ZeroPhone/ZeroPhoneNext-PCB/bottom_board_palmtop/FSUSB42UMX.stp

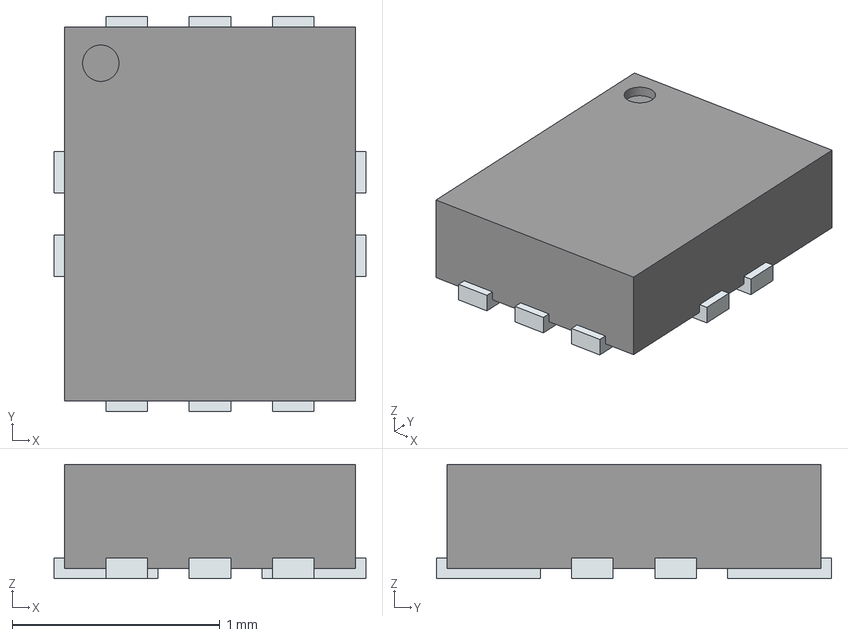
[picture p1: CAD file, 2026-03-20]
bottom_board_palmtop/FSUSB42UMX.stp
1.50 x 1.90 x 0.55 mm
PinsArrayLR
PinsArrayTB
