ZeroPhone/ZeroPhoneNext-PCB/top_board_pizero/CMNSM661004.stp

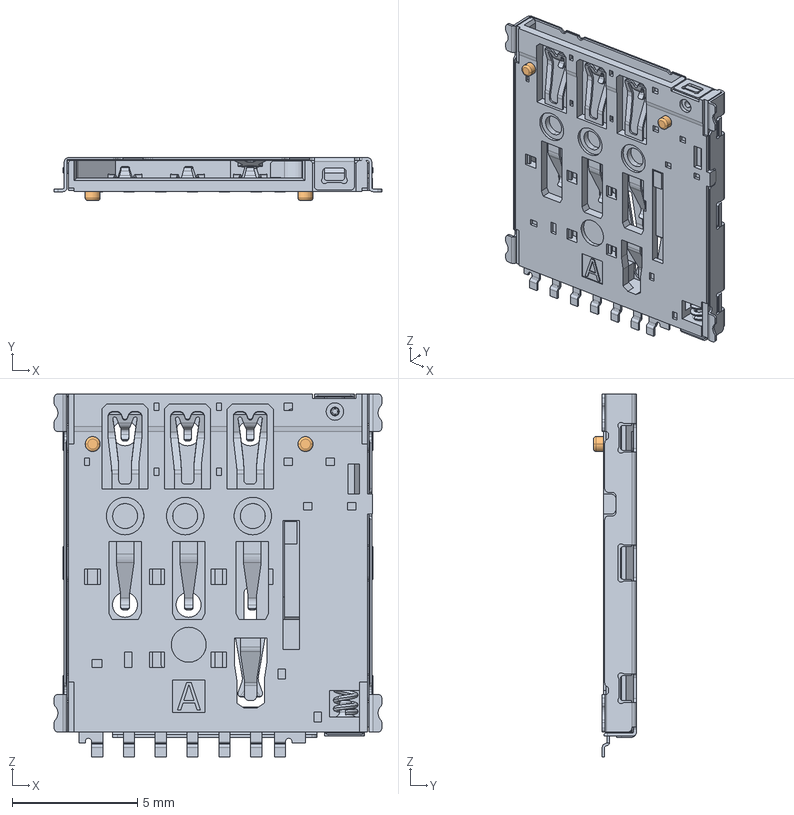
[picture p2: CAD file, 2026-03-20]
top_board_pizero/CMNSM661004.stp
13.1 x 1.72 x 14.5 mm
