ZeroPhone/ZeroPhoneNext-PCB/bottom_board_palmtop/battery.kicad_sch

## KiCad design bottom_board_palmtop/battery.kicad_sch (2026-03-31)

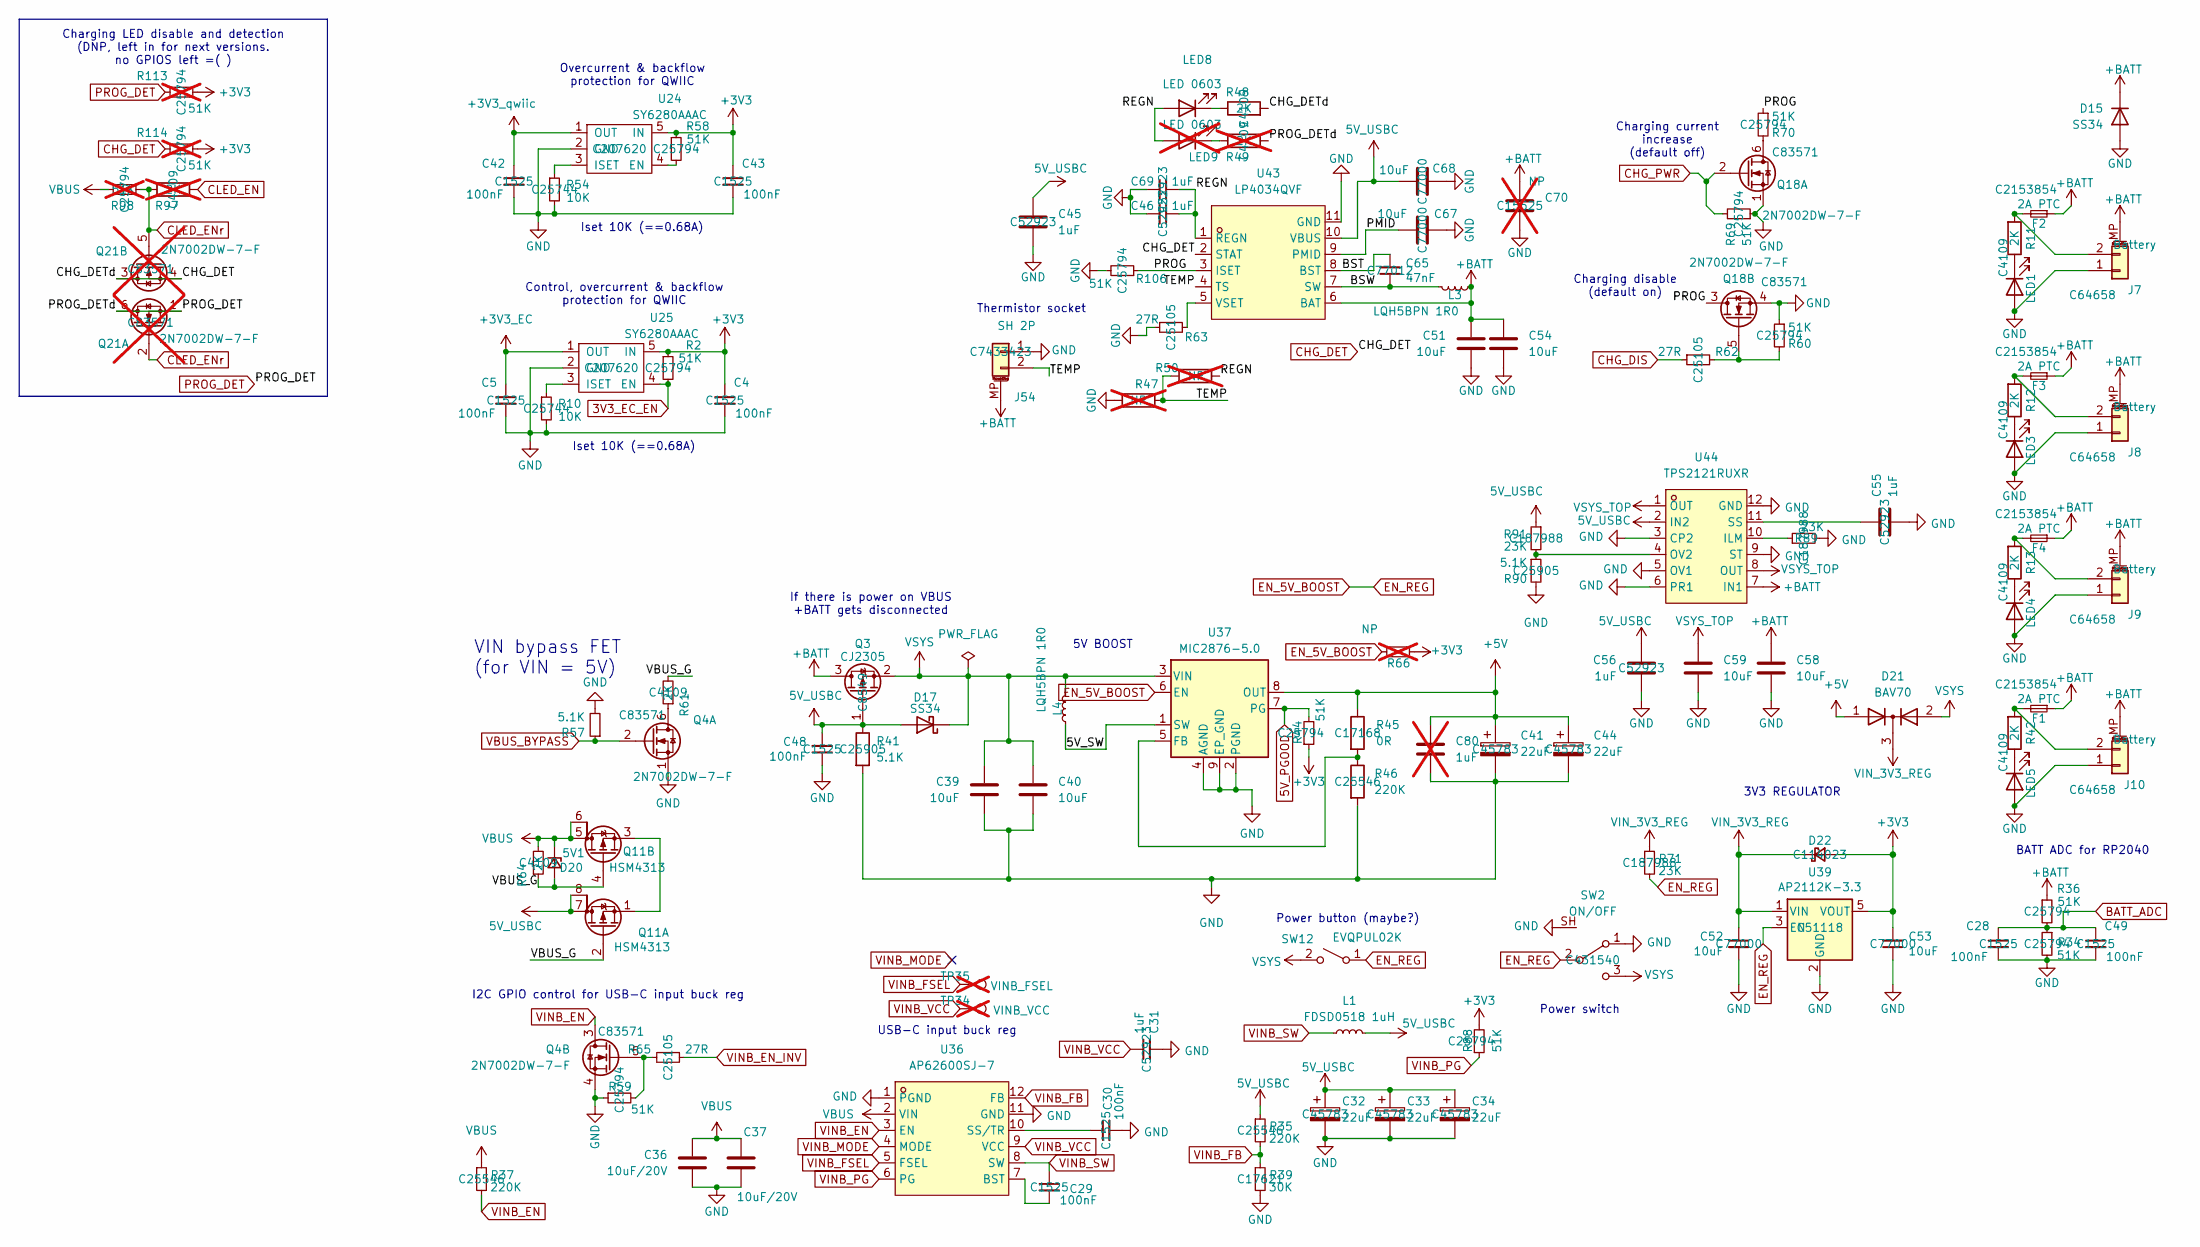
[picture p3: schematic battery.kicad_sch]

Parts:
C4, C5, C28, C29, C30, C42, C43, C48, C49: 100nF; C_0402_1005Metric; LCSC Part C1525
C31, C45, C46, C55, C56, C69: 1uF; C_0402_1005Metric; LCSC Part C52923
C32, C33, C34, C41, C44: 22uF; C_0805_2012Metric_Pad1.18x1.45mm_HandSolder; LCSC Part C45783
C36, C37: 10uF/20V; C_0805_2012Metric_Pad1.18x1.45mm_HandSolder
C39, C40, C51, C54, C58, C59: 10uF; C_0805_2012Metric_Pad1.18x1.45mm_HandSolder
C52, C53, C67, C68: 10uF; C_0402_1005Metric; LCSC Part C77000
C65: 47nF; C_0402_1005Metric; LCSC Part C77012
C70: NP; C_0402_1005Metric; LCSC Part C15525; not fitted
C80: 1uF; C_0805_2012Metric_Pad1.18x1.45mm_HandSolder; not fitted
D15, D17: SS34; D_SMA
D20: 5V1; D_0805_2012Metric
D21: BAV70; SOT-23; LCSC Part C2501
D22: D_Schottky_Small; D_SOD-323; LCSC Part C114023
F1, F2, F3, F4: 2A PTC; Fuse_1206_3216Metric; LCSC Part C2153854
J7, J8, J9, J10: Battery; JST_PH_B2B-PH-SM4-TB_1x02-1MP_P2.00mm_Vertical; LCSC Part C64658
J54: SH 2P; JST_SH_BM02B-SRSS-TB_1x02-1MP_P1.00mm_Vertical; LCSC Part C7433423
L1: FDSD0518 1uH; L_Murata_FDSD0518; LCSC Part C7511322
L3, L4: LQH5BPN 1R0; L_Murata_LQH5BPN; LCSC Part C337906
LED1, LED3, LED4, LED5: LED 0603 Orange; LED_0603_1608Metric; LCSC Part C965801
LED8: LED 0603; LED_0603_1608Metric; LCSC Part C965808
LED9: LED 0603; LED_0603_1608Metric; LCSC Part C965804; not fitted
Q3: CJ2305; SOT-23; LCSC Part C8549
Q4, Q18: 2N7002DW-7-F; SOT-363_SC-70-6; LCSC Part C83571
Q11: HSM4313; SO-8_3.9x4.9mm_P1.27mm
Q21: 2N7002DW-7-F; SOT-363_SC-70-6; LCSC Part C83571; not fitted
R2, R34, R36, R44, R58, R59, R60, R69, R70, R88, R106: 51K; R_0402_1005Metric; LCSC Part C25794
R10, R54: 10K; R_0402_1005Metric; LCSC Part C25744
R11, R12, R13, R42, R48, R61, R64: 2K; R_0402_1005Metric; LCSC Part C4109
R35, R37, R46: 220K; R_0402_1005Metric; LCSC Part C25546
R39: 30K; R_0402_1005Metric; LCSC Part C17621
R41, R57, R90: 5.1K; R_0402_1005Metric; LCSC Part C25905
R45: 0R; R_0402_1005Metric; LCSC Part C17168
R47, R50: NP; R_0603_1608Metric; not fitted
R49, R97: 2K; R_0402_1005Metric; LCSC Part C4109; not fitted
R62, R63, R65: 27R; R_0402_1005Metric; LCSC Part C25105
R66: NP; R_0402_1005Metric; LCSC Part C25794; not fitted
R71, R89, R91: 23K; R_0402_1005Metric; LCSC Part C187988
R98, R113, R114: 51K; R_0402_1005Metric; LCSC Part C25794; not fitted
SW2: ON/OFF; SW_SPDT_PCM12_SH; LCSC Part C431540
SW12: EVQPUL02K; Panasonic_EVQPUL_EVQPUC
TP34: VINB_VCC; TestPoint_Pad_0.6x0.6mm; not fitted
TP35: VINB_FSEL; TestPoint_Pad_0.6x0.6mm; not fitted
U24, U25: SY6280AAAC; SOT-23-5; LCSC Part C207620
U36: AP62600SJ-7; QFN-12_L3.0-W2.0-P0.50-TL_AP62600SJ-7; LCSC Part C4748917
U37: MIC2876-5.0; DFN-8-1EP_2x2mm_P0.5mm_EP0.6x1.2mm
U39: AP2112K-3.3; SOT-23-5; LCSC Part C51118
U43: LP4034QVF; DFN-10-1EP_3x3mm_P0.5mm_EP1.58x2.35mm; LCSC Part C42460070
U44: TPS2121RUXR; VQFN-HR-12_L2.5-W2.0-P0.50-BL; LCSC Part C485916

Connections:
3V3_EC_EN: R2.2, U25.4 (EN)
5V_PGOOD: R44.2, U37.7 (PG)
5V_SW: L4.1, U37.1 (SW)
5V_USBC: C32.1, C33.1, C34.1, C45.1, C48.2, C56.1, C68.1, D17.2 (A), L1.2, Q3.1 (G), Q11.7 (D), Q11.8 (G), R35.1, R41.1, R91.1, U43.10 (VBUS), U44.2 (IN2)
+3V3: C4.1, C43.1, C53.2, D22.2 (A), R2.1, R44.1, R58.1, R66.2, R88.2, R113.2, R114.2, U24.5 (IN), U25.5 (IN), U39.5 (VOUT)
+3V3_EC: C5.1, U25.1 (OUT)
+3V3_qwiic: C42.1, U24.1 (OUT)
+5V: C41.1, C44.1, C80.1, D21.1 (A), R45.1, U37.8 (OUT)
+BATT: C51.2, C54.2, C58.2, C70.1, D15.1 (K), F1.1, F2.1, F3.1, F4.1, J7.MP (MountPin), J8.MP (MountPin), J9.MP (MountPin), J10.MP (MountPin), J54.MP (MountPin), L3.1, Q3.3 (D), R36.1, U43.6 (BAT), U44.7 (IN1)
BATT_ADC: C28.1, C49.1, R34.1, R36.2
BST: C65.2, U43.8 (BST)
BSW: C65.1, L3.2, U43.7 (SW)
CHG_DET: Q21.3 (D), Q21.4 (S), R48.2, R114.1, U43.2 (STAT)
CHG_DIS: R62.1
CHG_PWR: Q18.2 (G), R69.2
CLED_EN: R97.2
CLED_ENr: Q21.2 (G), Q21.5 (G), R97.1, R98.2
EN_5V_BOOST: R66.1, R71.2, SW2.2 (B), SW12.1 (A), U37.6 (EN), U39.3 (EN)
GND: C4.2, C5.2, C28.2, C30.2, C31.2, C32.2, C33.2, C34.2, C36.1, C37.1, C39.1, C40.1, C41.2, C42.2, C43.2, C44.2, C45.2, C46.2, C48.1, C49.2, C51.1, C52.2, C53.1, C54.1, C55.2, C56.2, C58.1, C59.1, C67.2, C68.2, C69.2, C70.2, C80.2, D15.2 (A), J7.1, J8.1, J9.1, J10.1, J54.1, LED1.2 (A), LED3.2 (A), LED4.2 (A), LED5.2 (A), Q4.1 (S), Q4.4 (S), Q18.1 (S), Q18.4 (S), R10.2, R34.2, R39.2, R41.2, R46.2, R47.2, R54.2, R57.2, R59.1, R60.1, R63.1, R69.1, R89.2, R90.2, R106.2, SW2.1 (A), SW2.SH, U24.2 (GND), U25.2 (GND), U36.1 (PGND), U36.11 (GND), U37.2 (PGND), U37.4 (AGND), U37.9 (EP_GND), U39.2 (GND), U43.11 (GND), U44.3 (CP2), U44.5 (OV1), U44.6 (PR1), U44.9 (ST), U44.12 (GND)
unnamed: C29.2, U36.7 (BST)
unnamed: C30.1, U36.10 (SS/TR)
unnamed: C55.1, U44.11 (SS)
unnamed: F1.2, J10.2, R42.2
unnamed: F2.2, J7.2, R11.2
unnamed: F3.2, J8.2, R12.2
unnamed: F4.2, J9.2, R13.2
unnamed: LED1.1 (K), R11.1
unnamed: LED3.1 (K), R12.1
unnamed: LED4.1 (K), R13.1
unnamed: LED5.1 (K), R42.1
unnamed: LED8.1 (K), R48.1
unnamed: LED9.1 (K), R49.1
unnamed: Q4.5 (G), R59.2, R65.2
unnamed: Q4.6 (D), R61.1
unnamed: Q11.1 (S), Q11.3 (S)
unnamed: Q18.5 (G), R60.2, R62.2
unnamed: Q18.6 (D), R70.2
unnamed: R10.1, U25.3 (ISET)
unnamed: R45.2, R46.1, U37.5 (FB)
unnamed: R54.1, U24.3 (ISET)
unnamed: R58.2, U24.4 (EN)
unnamed: R63.2, U43.5 (VSET)
unnamed: R89.1, U44.10 (ILM)
unnamed: R90.1, R91.2, U44.4 (OV2)
PMID: C67.1, U43.9 (PMID)
PROG: Q18.3 (D), R70.1, R106.1, U43.3 (ISET)
PROG_DET: Q21.1 (S), Q21.6 (D), R49.2, R113.1
REGN: C46.1, C69.1, LED8.2 (A), LED9.2 (A), R50.1, U43.1 (REGN)
TEMP: J54.2, R47.1, R50.2, U43.4 (TS)
VBUS: C36.2, C37.2, D20.1 (K), Q11.5 (D), Q11.6 (G), R37.1, R64.2, R98.1, U36.2 (VIN)
VBUS_BYPASS: Q4.2 (G), R57.1
VBUS_G: D20.2 (A), Q11.2 (G), Q11.4 (G), R61.2, R64.1
VINB_EN: Q4.3 (D), R37.2, U36.3 (EN)
VINB_EN_INV: R65.1
VINB_FB: R35.2, R39.1, U36.12 (FB)
VINB_FSEL: TP35.1, U36.5 (FSEL)
VINB_MODE: U36.4 (MODE)
VINB_PG: R88.1, U36.6 (PG)
VINB_SW: C29.1, L1.1, U36.8 (SW)
VINB_VCC: C31.1, TP34.1, U36.9 (VCC)
VIN_3V3_REG: C52.1, D21.3 (K), D22.1 (K), R71.1, U39.1 (VIN)
VSYS: C39.2, C40.2, D17.1 (K), D21.2 (A), L4.2, Q3.2 (S), SW2.3 (C), SW12.2 (B), U37.3 (VIN)
VSYS_TOP: C59.2, U44.1 (OUT), U44.8 (OUT)

Notes on the sheet:
VIN bypass FET (for VIN = 5V)
5V BOOST
Power button (maybe?)
I2C GPIO control for USB-C input buck reg
Overcurrent & backflow protection for QWIIC
Iset 10K (==0.68A)
Control, overcurrent & backflow protection for QWIIC
Thermistor socket
BATT ADC for RP2040
Power switch
3V3 REGULATOR
If there is power on VBUS +BATT gets disconnected
Charging current increase (default off)
USB-C input buck reg
Charging disable (default on)
Charging LED disable and detection (DNP, left in for next versions. no GPIOS left =( )
