ZeroPhone/ZeroPhoneNext-PCB/bottom_board_palmtop/bottom_board_palmtop.kicad_sch

## KiCad design bottom_board_palmtop/bottom_board_palmtop.kicad_sch (2026-03-30)

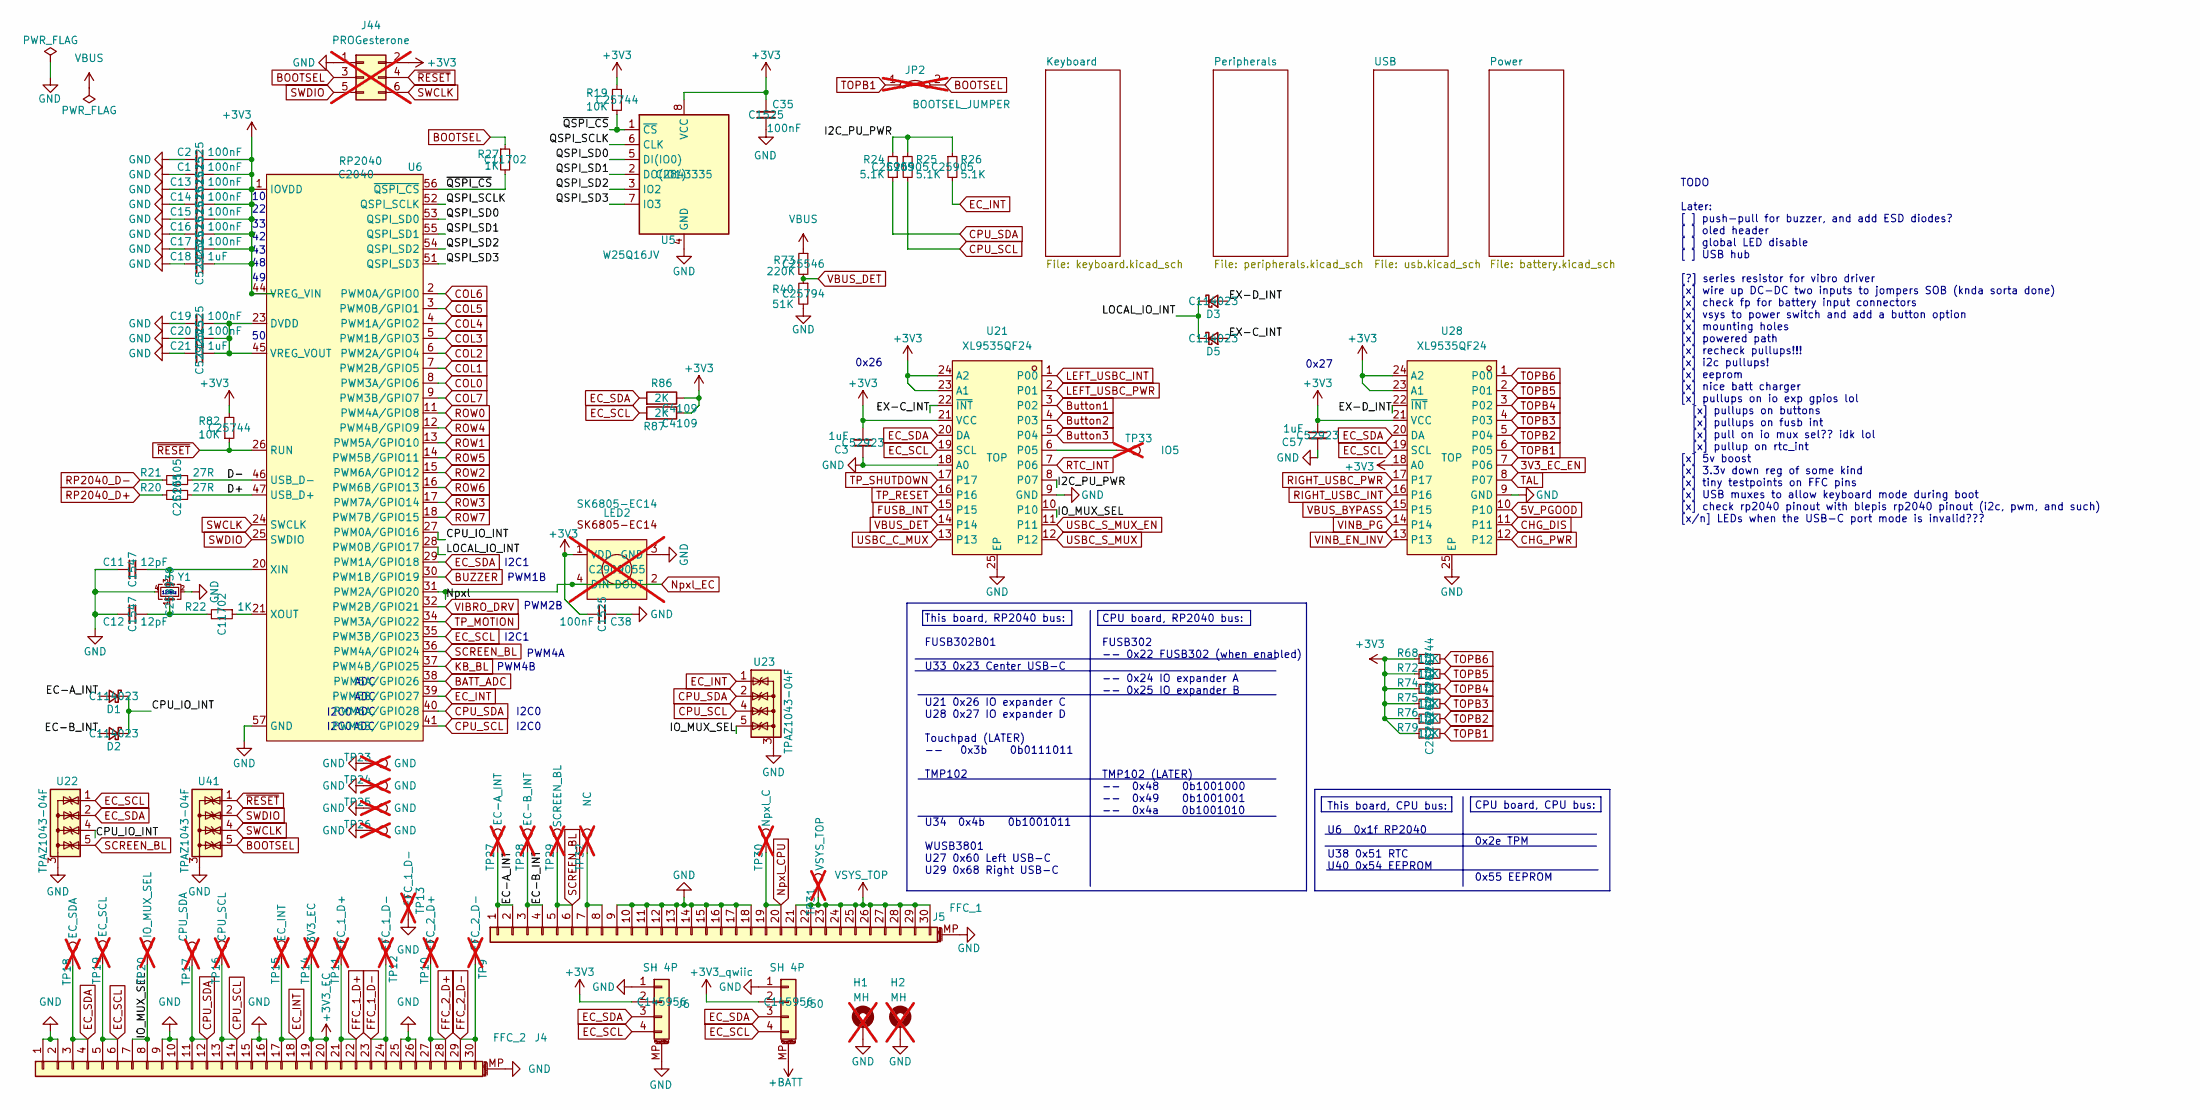
[picture p4: schematic bottom_board_palmtop.kicad_sch]

Parts:
C1, C2, C13, C14, C15, C16, C17, C19, C20, C35, C38: 100nF; C_0402_1005Metric; LCSC Part C1525
C3, C18, C21, C57: 1uF; C_0402_1005Metric; LCSC Part C52923
C11, C12: 12pF; C_0402_1005Metric; LCSC Part C1547
D1, D2, D3, D5: D_Schottky_Small; D_SOD-323; LCSC Part C114023
H1, H2: MH; MountingHole_2.5mm_Pad; not fitted
J4: FFC_2; FPC-SMD_30P-P0.50_XF3M-3015-1B; LCSC Part C5700582
J5: FFC_1; FPC-SMD_30P-P0.50_XF3M-3015-1B; LCSC Part C5700582
J6, J50: SH 4P; JST_SH_SM04B-SRSS-TB_1x04-1MP_P1.00mm_Horizontal; LCSC Part C145956
J44: PROGesterone; PinHeader_2x03_P2.54mm_Vertical_PROG; not fitted
JP2: BOOTSEL_JUMPER; SolderJumper-2_P1.3mm_Bridged_RoundedPad1.0x1.5mm; not fitted
LED2: SK6805-EC14; LCSC Part C2909055; not fitted
R19, R68, R72, R74, R75, R76, R79, R82: 10K; R_0402_1005Metric; LCSC Part C25744
R20, R21: 27R; R_0402_1005Metric; LCSC Part C25105
R22, R27: 1K; R_0402_1005Metric; LCSC Part C11702
R24, R25, R26: 5.1K; R_0402_1005Metric; LCSC Part C25905
R40: 51K; R_0402_1005Metric; LCSC Part C25794
R73: 220K; R_0402_1005Metric; LCSC Part C25546
R86, R87: 2K; R_0402_1005Metric; LCSC Part C4109
TP9: FFC_2_D-; TestPoint_Pad_0.6x0.6mm; not fitted
TP10: FFC_2_D+; TestPoint_Pad_0.6x0.6mm; not fitted
TP11: FFC_1_D+; TestPoint_Pad_0.6x0.6mm; not fitted
TP12, TP13: FFC_1_D-; TestPoint_Pad_0.6x0.6mm; not fitted
TP14: 3V3_EC; TestPoint_Pad_0.6x0.6mm; not fitted
TP15: EC_INT; TestPoint_Pad_0.6x0.6mm; not fitted
TP16: CPU_SCL; TestPoint_Pad_0.6x0.6mm; not fitted
TP17: CPU_SDA; TestPoint_Pad_0.6x0.6mm; not fitted
TP18: EC_SDA; TestPoint_Pad_0.6x0.6mm; not fitted
TP19: EC_SCL; TestPoint_Pad_0.6x0.6mm; not fitted
TP20: IO_MUX_SEL; TestPoint_Pad_0.6x0.6mm; not fitted
TP23, TP24, TP25, TP26: GND; TestPoint_Pad_0.6x0.6mm; not fitted
TP27: EC-A_INT; TestPoint_Pad_0.6x0.6mm; not fitted
TP28: EC-B_INT; TestPoint_Pad_0.6x0.6mm; not fitted
TP29: SCREEN_BL; TestPoint_Pad_0.6x0.6mm; not fitted
TP30: Npxl_C; TestPoint_Pad_0.6x0.6mm; not fitted
TP31: VSYS_TOP; TestPoint_Pad_0.6x0.6mm; not fitted
TP32: NC; TestPoint_Pad_0.6x0.6mm; not fitted
TP33: IO5; TestPoint_Pad_0.6x0.6mm; not fitted
U5: W25Q16JV; DFN-8-1EP_3x2mm_P0.5mm_EP1.3x1.5mm; LCSC Part C2843335
U6: RP2040; QFN-56-1EP_7x7mm_P0.4mm_EP5.6x5.6mm; LCSC Part C2040
U21, U28: XL9535QF24; QFN-24-1EP_4x4mm_P0.5mm_EP2.5x2.5mm; LCSC Part C5444301
U22, U23, U41: TPAZ1043-04F; USON-10_2.5x1.0mm_P0.5mm
Y1: 12MHz; Crystal_SMD_3225-4Pin_3.2x2.5mm; LCSC Part C258938

Connections:
3V3_EC_EN: U28.7 (P06)
5V_PGOOD: U28.10
+3V3: C1.1, C2.1, C3.1, C13.1, C14.1, C15.1, C16.1, C17.1, C18.1, C35.1, C38.1, C57.1, J6.2, J44.2, LED2.1 (VDD), R19.2, R68.1, R72.1, R74.1, R75.1, R76.1, R79.1, R82.2, R86.1, R87.1, U5.8 (VCC), U6.1 (IOVDD), U6.10 (IOVDD), U6.22 (IOVDD), U6.33 (IOVDD), U6.42 (IOVDD), U6.43 (ADC_AVDD), U6.44 (VREG_VIN), U6.48 (USB_VDD), U6.49 (IOVDD), U21.21 (VCC), U21.23 (A1), U21.24 (A2), U28.18 (A0), U28.21 (VCC), U28.23 (A1), U28.24 (A2)
+3V3_EC: J4.19, J4.20, TP14.1
+3V3_qwiic: J50.2
+BATT: J50.MP (MountPin)
BATT_ADC: U6.38 (PWM5A/GPIO26)
BOOTSEL: J44.3, JP2.2 (B), R27.1, U41.5 (IO4), U41.6 (NC)
BUZZER: U6.30 (PWM1B/GPIO19)
Button1: U21.3 (P02)
Button2: U21.4 (P03)
Button3: U21.5 (P04)
CHG_DIS: U28.11
CHG_PWR: U28.12
COL0: U6.8 (PWM3A/GPIO6)
COL1: U6.7 (PWM2B/GPIO5)
COL2: U6.6 (PWM2A/GPIO4)
COL3: U6.5 (PWM1B/GPIO3)
COL4: U6.4 (PWM1A/GPIO2)
COL5: U6.3 (PWM0B/GPIO1)
COL6: U6.2 (PWM0A/GPIO0)
COL7: U6.9 (PWM3B/GPIO7)
CPU_IO_INT: D1.1 (K), D2.1 (K), U6.27 (PWM0A/GPIO16), U22.4 (IO3), U22.7 (NC)
CPU_SCL: J4.13, J4.14, R25.2, TP16.1, U6.41 (PWM6B/GPIO29), U23.4 (IO3), U23.7 (NC)
CPU_SDA: J4.11, J4.12, R24.1, TP17.1, U6.40 (PWM6A/GPIO28), U23.2 (IO2), U23.9 (NC)
D+: R20.1, U6.47 (USB_D+)
D-: R21.1, U6.46 (USB_D-)
EC-A_INT: D1.2 (A), J5.1, J5.2, TP27.1
EC-B_INT: D2.2 (A), J5.3, J5.4, TP28.1
EC_INT: J4.17, J4.18, R26.2, TP15.1, U6.39 (PWM5B/GPIO27), U23.1 (IO1), U23.10 (NC)
EC_SCL: J4.5, J4.6, J6.4, J50.4, R87.2, TP19.1, U6.35 (PWM3B/GPIO23), U21.19 (SCL), U22.1 (IO1), U22.10 (NC), U28.19 (SCL)
EC_SDA: J4.3, J4.4, J6.3, J50.3, R86.2, TP18.1, U6.29 (PWM1A/GPIO18), U21.20 (DA), U22.2 (IO2), U22.9 (NC), U28.20 (DA)
EX-C_INT: D5.2 (A), U21.22 (~INT)
EX-D_INT: D3.2 (A), U28.22 (~INT)
FFC_1_D+: J4.21, J4.22, TP11.1
FFC_1_D-: J4.23, J4.24, TP12.1
FFC_2_D+: J4.27, J4.28, TP10.1
FFC_2_D-: J4.29, J4.30, TP9.1
FUSB_INT: U21.15
GND: C1.2, C2.2, C3.2, C11.2, C12.2, C13.2, C14.2, C15.2, C16.2, C17.2, C18.2, C19.2, C20.2, C21.2, C35.2, C38.2, C57.2, H1.1, H2.1, J4.1, J4.2, J4.9, J4.10, J4.15, J4.16, J4.25, J4.26, J4.MP (MountPin), J5.9, J5.10, J5.11, J5.12, J5.13, J5.14, J5.15, J5.16, J5.17, J5.18, J5.MP (MountPin), J6.1, J6.MP (MountPin), J44.1, J50.1, LED2.3 (GND), R40.2, TP13.1, TP23.1, TP24.1, TP25.1, TP26.1, U5.4 (GND), U6.19 (TESTEN), U6.57 (GND), U21.9 (GND), U21.18 (A0), U21.25 (EP), U22.3 (G), U22.8 (G), U23.3 (G), U23.8 (G), U28.9 (GND), U28.25 (EP), U41.3 (G), U41.8 (G), Y1.2, Y1.4
I2C_PU_PWR: R24.2, R25.1, R26.1, U21.8 (P07)
IO_MUX_SEL: J4.7, J4.8, TP20.1, U21.10, U23.5 (IO4), U23.6 (NC)
KB_BL: U6.37 (PWM4B/GPIO25)
LEFT_USBC_INT: U21.1 (P00)
LEFT_USBC_PWR: U21.2 (P01)
LOCAL_IO_INT: D3.1 (K), D5.1 (K), U6.28 (PWM0B/GPIO17)
unnamed: C11.1, U6.20 (XIN), Y1.3
unnamed: C12.1, R22.2, Y1.1
unnamed: C19.1, C20.1, C21.1, U6.23 (DVDD), U6.45 (VREG_VOUT), U6.50 (DVDD)
unnamed: J5.7, J5.8, TP32.1
unnamed: R22.1, U6.21 (XOUT)
unnamed: TP33.1, U21.6 (P05)
Npxl_CPU: J5.19, J5.20, TP30.1
Npxl_EC: LED2.2 (DOUT), LED2.4 (DIN), U6.31 (PWM2A/GPIO20)
QSPI_SCLK: U5.6 (CLK), U6.52 (QSPI_SCLK)
QSPI_SD0: U5.5 (DI(IO0)), U6.53 (QSPI_SD0)
QSPI_SD1: U5.2 (DO(IO1)), U6.55 (QSPI_SD1)
QSPI_SD2: U5.3 (IO2), U6.54 (QSPI_SD2)
QSPI_SD3: U5.7 (IO3), U6.51 (QSPI_SD3)
RIGHT_USBC_INT: U28.16
RIGHT_USBC_PWR: U28.17
ROW0: U6.11 (PWM4A/GPIO8)
ROW1: U6.13 (PWM5A/GPIO10)
ROW2: U6.15 (PWM6A/GPIO12)
ROW3: U6.17 (PWM7A/GPIO14)
ROW4: U6.12 (PWM4B/GPIO9)
ROW5: U6.14 (PWM5B/GPIO11)
ROW6: U6.16 (PWM6B/GPIO13)
ROW7: U6.18 (PWM7B/GPIO15)
RP2040_D+: R20.2
RP2040_D-: R21.2
RTC_INT: U21.7 (P06)
SCREEN_BL: J5.5, J5.6, TP29.1, U6.36 (PWM4A/GPIO24), U22.5 (IO4), U22.6 (NC)
SWCLK: J44.6, U6.24 (SWCLK), U41.4 (IO3), U41.7 (NC)
SWDIO: J44.5, U6.25 (SWDIO), U41.2 (IO2), U41.9 (NC)
TAL: U28.8 (P07)
TOPB1: JP2.1 (A), R79.2, U28.6 (P05)
TOPB2: R76.2, U28.5 (P04)
TOPB3: R75.2, U28.4 (P03)
TOPB4: R74.2, U28.3 (P02)
TOPB5: R72.2, U28.2 (P01)
TOPB6: R68.2, U28.1 (P00)
TP_MOTION: U6.34 (PWM3A/GPIO22)
TP_RESET: U21.16
TP_SHUTDOWN: U21.17
USBC_C_MUX: U21.13
USBC_S_MUX: U21.12
USBC_S_MUX_EN: U21.11
VBUS: R73.1
VBUS_BYPASS: U28.15
VBUS_DET: R40.1, R73.2, U21.14
VIBRO_DRV: U6.32 (PWM2B/GPIO21)
VINB_EN_INV: U28.13
VINB_PG: U28.14
VSYS_TOP: J5.21, J5.22, J5.23, J5.24, J5.25, J5.26, J5.27, J5.28, J5.29, J5.30, TP31.1
~QSPI_CS: R19.1, R27.2, U5.1 (~CS), U6.56 (~QSPI_CS)
~RESET: J44.4, R82.1, U6.26 (RUN), U41.1 (IO1), U41.10 (NC)

Notes on the sheet:
0x26
ADC
PWM4B
PWM1B
I2C0
PWM4A
This board, RP2040 bus: FUSB302B01 U33 0x23 Center USB-C U21 0x26 IO expander C U28 0x27 IO expander D Touchpad (LATER) -- 0x3b 0b0111011 TMP102 U34 0x4b 0b1001011 WUSB3801 U27 0x60 Left USB-C U29 0x68 Right USB-C
I2C0
PWM2B
This board, CPU bus: U6 0x1f RP2040 U38 0x51 RTC U40 0x54 EEPROM
0x27
TODO Later: [ ] push-pull for buzzer, and add ESD diodes? [ ] oled header [ ] global LED disable [ ] USB hub [?] series resistor for vibro driver [x] wire up DC-DC two inputs to jompers SOB (knda sorta done) [x] check fp for battery input connectors [x] vsys to power switch and add a button option 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
CPU board, CPU bus: 0x2e TPM 0x55 EEPROM
I2C1
12MHz
CPU board, RP2040 bus: FUSB302 -- 0x22 FUSB302 (when enabled) -- 0x24 IO expander A -- 0x25 IO expander B TMP102 (LATER) -- 0x48 0b1001000 -- 0x49 0b1001001 -- 0x4a 0b1001010
