ZeroPhone/ZeroPhoneNext-PCB/bottom_board_palmtop/keyboard.kicad_sch

## KiCad design bottom_board_palmtop/keyboard.kicad_sch (2026-03-30)

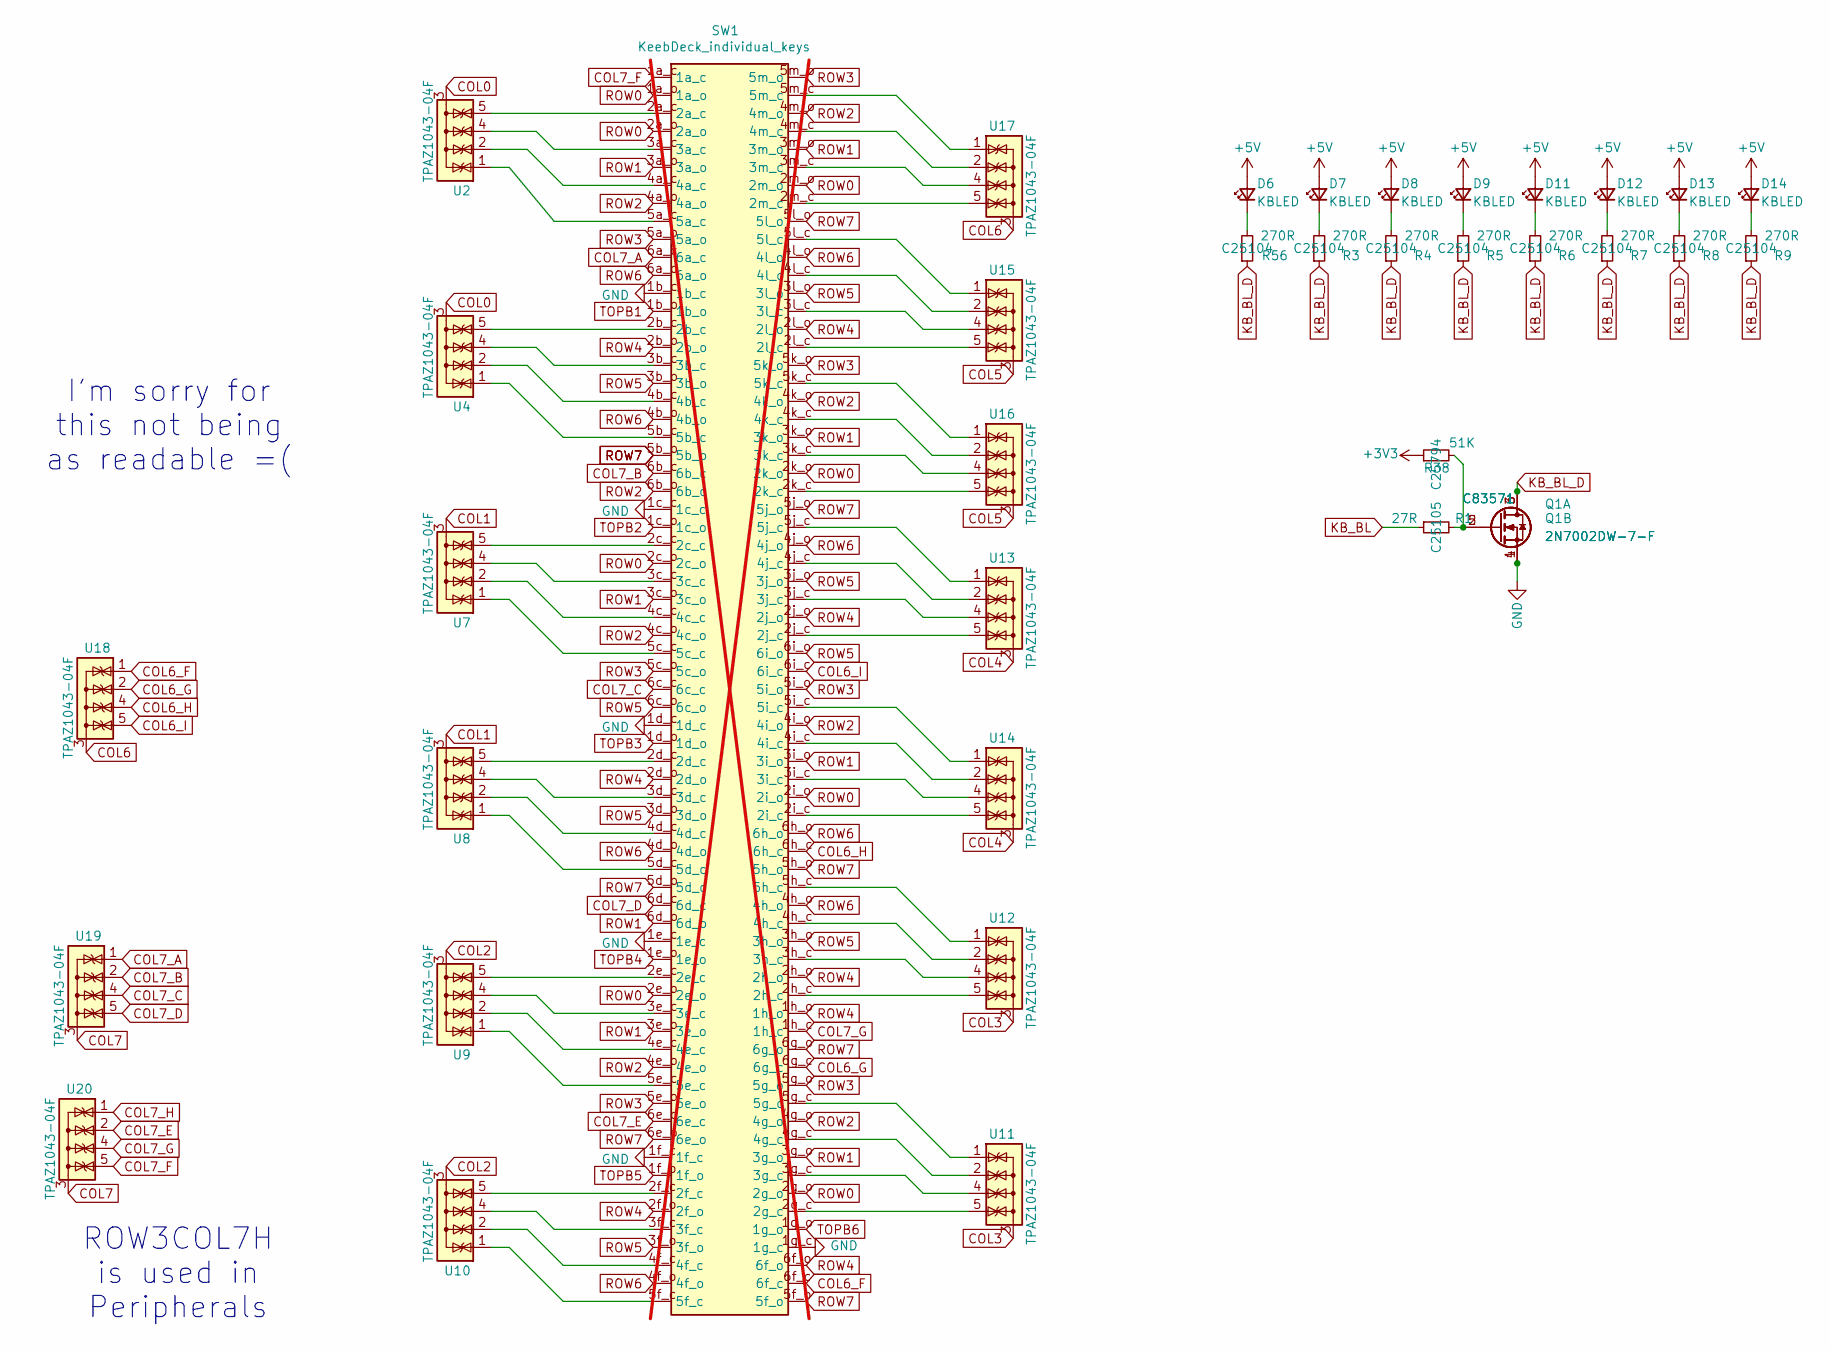
[picture p5: schematic keyboard.kicad_sch]

Parts:
D6, D7, D8, D9, D11, D12, D13, D14: KBLED; LTW-010DCG
Q1: 2N7002DW-7-F; SOT-363_SC-70-6; LCSC Part C83571
R1: 27R; R_0402_1005Metric; LCSC Part C25105
R3, R4, R5, R6, R7, R8, R9, R56: 270R; R_0402_1005Metric; LCSC Part C25104
R38: 51K; R_0402_1005Metric; LCSC Part C25794
SW1: KeebDeck_individual_keys; Keyboard_6R13C_IND; not fitted
U2, U4, U7, U8, U9, U10, U11, U12, U13, U14, U15, U16, U17, U18, U19, U20: TPAZ1043-04F; USON-10_2.5x1.0mm_P0.5mm

Connections:
+3V3: R38.1
+5V: D6.2 (A), D7.2 (A), D8.2 (A), D9.2 (A), D11.2 (A), D12.2 (A), D13.2 (A), D14.2 (A)
COL0: U2.3 (G), U2.8 (G), U4.3 (G), U4.8 (G)
COL1: U7.3 (G), U7.8 (G), U8.3 (G), U8.8 (G)
COL2: U9.3 (G), U9.8 (G), U10.3 (G), U10.8 (G)
COL3: U11.3 (G), U11.8 (G), U12.3 (G), U12.8 (G)
COL4: U13.3 (G), U13.8 (G), U14.3 (G), U14.8 (G)
COL5: U15.3 (G), U15.8 (G), U16.3 (G), U16.8 (G)
COL6: U17.3 (G), U17.8 (G), U18.3 (G), U18.8 (G)
COL6_F: SW1.6f_c, U18.1 (IO1), U18.10 (NC)
COL6_G: SW1.6g_c, U18.2 (IO2), U18.9 (NC)
COL6_H: SW1.6h_c, U18.4 (IO3), U18.7 (NC)
COL6_I: SW1.6i_c, U18.5 (IO4), U18.6 (NC)
COL7: U19.3 (G), U19.8 (G), U20.3 (G), U20.8 (G)
COL7_A: SW1.6a_c, U19.1 (IO1), U19.10 (NC)
COL7_B: SW1.6b_c, U19.2 (IO2), U19.9 (NC)
COL7_C: SW1.6c_c, U19.4 (IO3), U19.7 (NC)
COL7_D: SW1.6d_c, U19.5 (IO4), U19.6 (NC)
COL7_E: SW1.6e_c, U20.2 (IO2), U20.9 (NC)
COL7_F: SW1.1a_c, U20.5 (IO4), U20.6 (NC)
COL7_G: SW1.1h_c, U20.4 (IO3), U20.7 (NC)
COL7_H: U20.1 (IO1), U20.10 (NC)
GND: Q1.1 (S), Q1.4 (S), SW1.1b_c, SW1.1c_c, SW1.1d_c, SW1.1e_c, SW1.1f_c, SW1.1g_c
KB_BL: R1.1
KB_BL_D: Q1.3 (D), Q1.6 (D), R3.1, R4.1, R5.1, R6.1, R7.1, R8.1, R9.1, R56.1
unnamed: D6.1 (K), R56.2
unnamed: D7.1 (K), R3.2
unnamed: D8.1 (K), R4.2
unnamed: D9.1 (K), R5.2
unnamed: D11.1 (K), R6.2
unnamed: D12.1 (K), R7.2
unnamed: D13.1 (K), R8.2
unnamed: D14.1 (K), R9.2
unnamed: Q1.2 (G), Q1.5 (G), R1.2, R38.2
unnamed: SW1.2a_c, U2.5 (IO4), U2.6 (NC)
unnamed: SW1.2b_c, U4.5 (IO4), U4.6 (NC)
unnamed: SW1.2c_c, U7.5 (IO4), U7.6 (NC)
unnamed: SW1.2d_c, U8.5 (IO4), U8.6 (NC)
unnamed: SW1.2e_c, U9.5 (IO4), U9.6 (NC)
unnamed: SW1.2f_c, U10.5 (IO4), U10.6 (NC)
unnamed: SW1.2g_c, U11.5 (IO4), U11.6 (NC)
unnamed: SW1.2h_c, U12.5 (IO4), U12.6 (NC)
unnamed: SW1.2i_c, U14.5 (IO4), U14.6 (NC)
unnamed: SW1.2j_c, U13.5 (IO4), U13.6 (NC)
unnamed: SW1.2k_c, U16.5 (IO4), U16.6 (NC)
unnamed: SW1.2l_c, U15.5 (IO4), U15.6 (NC)
unnamed: SW1.2m_c, U17.5 (IO4), U17.6 (NC)
unnamed: SW1.3a_c, U2.4 (IO3), U2.7 (NC)
unnamed: SW1.3b_c, U4.4 (IO3), U4.7 (NC)
unnamed: SW1.3c_c, U7.4 (IO3), U7.7 (NC)
unnamed: SW1.3d_c, U8.4 (IO3), U8.7 (NC)
unnamed: SW1.3e_c, U9.4 (IO3), U9.7 (NC)
unnamed: SW1.3f_c, U10.4 (IO3), U10.7 (NC)
unnamed: SW1.3g_c, U11.4 (IO3), U11.7 (NC)
unnamed: SW1.3h_c, U12.4 (IO3), U12.7 (NC)
unnamed: SW1.3i_c, U14.4 (IO3), U14.7 (NC)
unnamed: SW1.3j_c, U13.4 (IO3), U13.7 (NC)
unnamed: SW1.3k_c, U16.4 (IO3), U16.7 (NC)
unnamed: SW1.3l_c, U15.4 (IO3), U15.7 (NC)
unnamed: SW1.3m_c, U17.4 (IO3), U17.7 (NC)
unnamed: SW1.4a_c, U2.2 (IO2), U2.9 (NC)
unnamed: SW1.4b_c, U4.2 (IO2), U4.9 (NC)
unnamed: SW1.4c_c, U7.2 (IO2), U7.9 (NC)
unnamed: SW1.4d_c, U8.2 (IO2), U8.9 (NC)
unnamed: SW1.4e_c, U9.2 (IO2), U9.9 (NC)
unnamed: SW1.4f_c, U10.2 (IO2), U10.9 (NC)
unnamed: SW1.4g_c, U11.2 (IO2), U11.9 (NC)
unnamed: SW1.4h_c, U12.2 (IO2), U12.9 (NC)
unnamed: SW1.4i_c, U14.2 (IO2), U14.9 (NC)
unnamed: SW1.4j_c, U13.2 (IO2), U13.9 (NC)
unnamed: SW1.4k_c, U16.2 (IO2), U16.9 (NC)
unnamed: SW1.4l_c, U15.2 (IO2), U15.9 (NC)
unnamed: SW1.4m_c, U17.2 (IO2), U17.9 (NC)
unnamed: SW1.5a_c, U2.1 (IO1), U2.10 (NC)
unnamed: SW1.5b_c, U4.1 (IO1), U4.10 (NC)
unnamed: SW1.5c_c, U7.1 (IO1), U7.10 (NC)
unnamed: SW1.5d_c, U8.1 (IO1), U8.10 (NC)
unnamed: SW1.5e_c, U9.1 (IO1), U9.10 (NC)
unnamed: SW1.5f_c, U10.1 (IO1), U10.10 (NC)
unnamed: SW1.5g_c, U11.1 (IO1), U11.10 (NC)
unnamed: SW1.5h_c, U12.1 (IO1), U12.10 (NC)
unnamed: SW1.5i_c, U14.1 (IO1), U14.10 (NC)
unnamed: SW1.5j_c, U13.1 (IO1), U13.10 (NC)
unnamed: SW1.5k_c, U16.1 (IO1), U16.10 (NC)
unnamed: SW1.5l_c, U15.1 (IO1), U15.10 (NC)
unnamed: SW1.5m_c, U17.1 (IO1), U17.10 (NC)
ROW0: SW1.1a_o, SW1.2a_o, SW1.2c_o, SW1.2e_o, SW1.2g_o, SW1.2i_o, SW1.2k_o, SW1.2m_o
ROW1: SW1.3a_o, SW1.3c_o, SW1.3e_o, SW1.3g_o, SW1.3i_o, SW1.3k_o, SW1.3m_o, SW1.6d_o
ROW2: SW1.4a_o, SW1.4c_o, SW1.4e_o, SW1.4g_o, SW1.4i_o, SW1.4k_o, SW1.4m_o, SW1.6b_o
ROW3: SW1.5a_o, SW1.5c_o, SW1.5e_o, SW1.5g_o, SW1.5i_o, SW1.5k_o, SW1.5m_o
ROW4: SW1.1h_o, SW1.2b_o, SW1.2d_o, SW1.2f_o, SW1.2h_o, SW1.2j_o, SW1.2l_o, SW1.6f_o
ROW5: SW1.3b_o, SW1.3d_o, SW1.3f_o, SW1.3h_o, SW1.3j_o, SW1.3l_o, SW1.6c_o, SW1.6i_o
ROW6: SW1.4b_o, SW1.4d_o, SW1.4f_o, SW1.4h_o, SW1.4j_o, SW1.4l_o, SW1.6a_o, SW1.6h_o
ROW7: SW1.5b_o, SW1.5d_o, SW1.5f_o, SW1.5h_o, SW1.5j_o, SW1.5l_o, SW1.6e_o, SW1.6g_o
TOPB1: SW1.1b_o
TOPB2: SW1.1c_o
TOPB3: SW1.1d_o
TOPB4: SW1.1e_o
TOPB5: SW1.1f_o
TOPB6: SW1.1g_o

Notes on the sheet:
ROW3COL7H is used in Peripherals
I'm sorry for this not being as readable =(
