ZeroPhone/ZeroPhoneNext-PCB/bottom_board_palmtop/peripherals.kicad_sch

## KiCad design bottom_board_palmtop/peripherals.kicad_sch (2026-03-31)

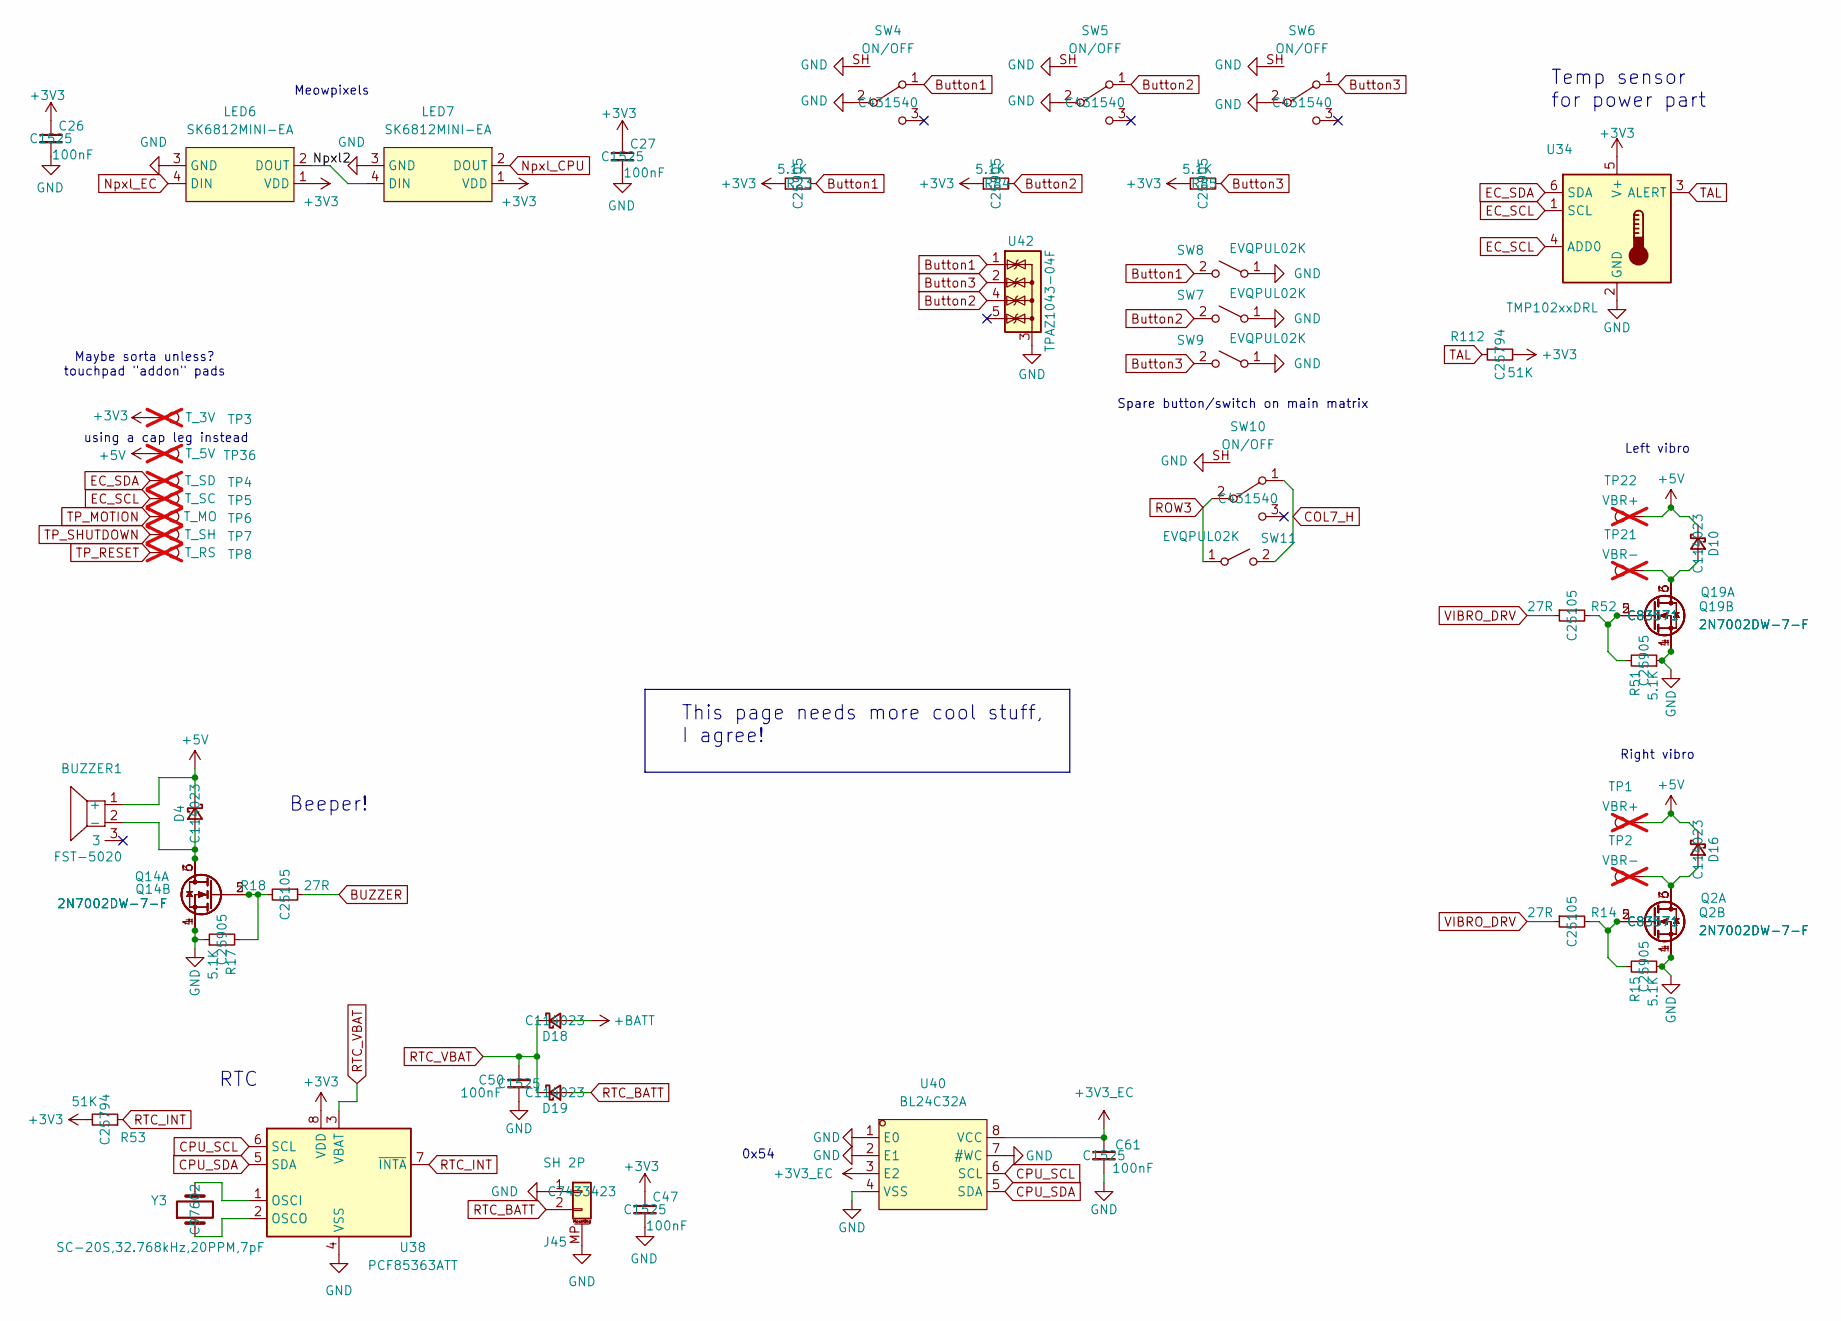
[picture p6: schematic peripherals.kicad_sch]

Parts:
BUZZER1: FST-5020; BUZ-SMD_FST-5020; LCSC Part C391029
C26, C27, C47, C50, C61: 100nF; C_0402_1005Metric; LCSC Part C1525
D4, D10, D16, D18, D19: D_Schottky_Small; D_SOD-323; LCSC Part C114023
J45: SH 2P; JST_SH_BM02B-SRSS-TB_1x02-1MP_P1.00mm_Vertical; LCSC Part C7433423
LED6, LED7: SK6812MINI-EA; LED-SMD_4P-L3.2-W2.8_SK6812MINI-EA; LCSC Part C5378731
Q2, Q14, Q19: 2N7002DW-7-F; SOT-363_SC-70-6; LCSC Part C83571
R14, R18, R52: 27R; R_0402_1005Metric; LCSC Part C25105
R15, R17, R23, R51, R84, R85: 5.1K; R_0402_1005Metric; LCSC Part C25905
R53, R112: 51K; R_0402_1005Metric; LCSC Part C25794
SW4, SW5, SW6, SW10: ON/OFF; SW_SPDT_PCM12_SH; LCSC Part C431540
SW7, SW8, SW9, SW11: EVQPUL02K; Panasonic_EVQPUL_EVQPUC
TP1, TP22: VBR+; TestPoint_Pad_1.0x1.0mm; not fitted
TP2, TP21: VBR-; TestPoint_Pad_1.0x1.0mm; not fitted
TP3: T_3V; TestPoint_Pad_0.6x0.6mm; not fitted
TP4: T_SD; TestPoint_Pad_0.6x0.6mm; not fitted
TP5: T_SC; TestPoint_Pad_0.6x0.6mm; not fitted
TP6: T_MO; TestPoint_Pad_0.6x0.6mm; not fitted
TP7: T_SH; TestPoint_Pad_0.6x0.6mm; not fitted
TP8: T_RS; TestPoint_Pad_0.6x0.6mm; not fitted
TP36: T_5V; TestPoint_Pad_0.6x0.6mm; not fitted
U34: TMP102xxDRL; SOT-563; LCSC Part C99269
U38: PCF85363ATT; TSSOP-8_3x3mm_P0.65mm
U40: BL24C32A; DFN-8-1EP_3x2mm_P0.5mm_EP1.3x1.5mm; LCSC Part C691878
U42: TPAZ1043-04F; USON-10_2.5x1.0mm_P0.5mm
Y3: SC-20S,32.768kHz,20PPM,7pF; Crystal_SMD_TXC_9HT11-2Pin_2.0x1.2mm; LCSC Part C97602

Connections:
+3V3: C26.1, C27.1, C47.1, LED6.1 (VDD), LED7.1 (VDD), R23.1, R53.2, R84.1, R85.1, R112.2, TP3.1, U34.5 (V+), U38.8 (VDD)
+3V3_EC: C61.1, U40.3 (E2), U40.8 (VCC)
+5V: BUZZER1.1 (+), D4.1 (K), D10.1 (K), D16.1 (K), TP1.1, TP22.1, TP36.1
+BATT: D18.2 (A)
BUZZER: R18.1
Button1: R23.2, SW4.1 (A), SW8.2 (B), U42.1 (IO1), U42.10 (NC)
Button2: R84.2, SW5.1 (A), SW7.2 (B), U42.4 (IO3), U42.7 (NC)
Button3: R85.2, SW6.1 (A), SW9.2 (B), U42.2 (IO2), U42.9 (NC)
COL7_H: SW10.1 (A), SW11.2 (B)
CPU_SCL: U38.6 (SCL), U40.6 (SCL)
CPU_SDA: U38.5 (SDA), U40.5 (SDA)
EC_SCL: TP5.1, U34.1 (SCL), U34.4 (ADD0)
EC_SDA: TP4.1, U34.6 (SDA)
GND: C26.2, C27.2, C47.2, C50.1, C61.2, J45.1, J45.MP (MountPin), LED6.3 (GND), LED7.3 (GND), Q2.1 (S), Q2.4 (S), Q14.1 (S), Q14.4 (S), Q19.1 (S), Q19.4 (S), R15.1, R17.1, R51.1, SW4.2 (B), SW4.SH, SW5.2 (B), SW5.SH, SW6.2 (B), SW6.SH, SW7.1 (A), SW8.1 (A), SW9.1 (A), SW10.SH, U34.2 (GND), U38.4 (VSS), U40.1 (E0), U40.2 (E1), U40.4 (VSS), U40.7 (#WC), U42.3 (G), U42.8 (G)
unnamed: BUZZER1.2 (-), D4.2 (A), Q14.3 (D), Q14.6 (D)
unnamed: D10.2 (A), Q19.3 (D), Q19.6 (D), TP21.1
unnamed: D16.2 (A), Q2.3 (D), Q2.6 (D), TP2.1
unnamed: Q2.2 (G), Q2.5 (G), R14.2, R15.2
unnamed: Q14.2 (G), Q14.5 (G), R17.2, R18.2
unnamed: Q19.2 (G), Q19.5 (G), R51.2, R52.2
unnamed: U38.1 (OSCI), Y3.2
unnamed: U38.2 (OSCO), Y3.1
unnamed: U42.5 (IO4), U42.6 (NC)
Npxl2: LED6.2 (DOUT), LED7.4 (DIN)
Npxl_CPU: LED7.2 (DOUT)
Npxl_EC: LED6.4 (DIN)
ROW3: SW10.2 (B), SW11.1 (A)
RTC_BATT: D19.2 (A), J45.2
RTC_INT: R53.1, U38.7 (~INTA)
RTC_VBAT: C50.2, D18.1 (K), D19.1 (K), U38.3 (VBAT)
TAL: R112.1, U34.3 (ALERT)
TP_MOTION: TP6.1
TP_RESET: TP8.1
TP_SHUTDOWN: TP7.1
VIBRO_DRV: R14.1, R52.1

Notes on the sheet:
Meowpixels
Temp sensor for power part
Right vibro
RTC
0x54
Beeper!
using a cap leg instead
Left vibro
Spare button/switch on main matrix
Maybe sorta unless? touchpad "addon" pads
This page needs more cool stuff, I agree!
