ZeroPhone/ZeroPhoneNext-PCB/bottom_board_palmtop/usb.kicad_sch

## KiCad design bottom_board_palmtop/usb.kicad_sch (2026-03-30)

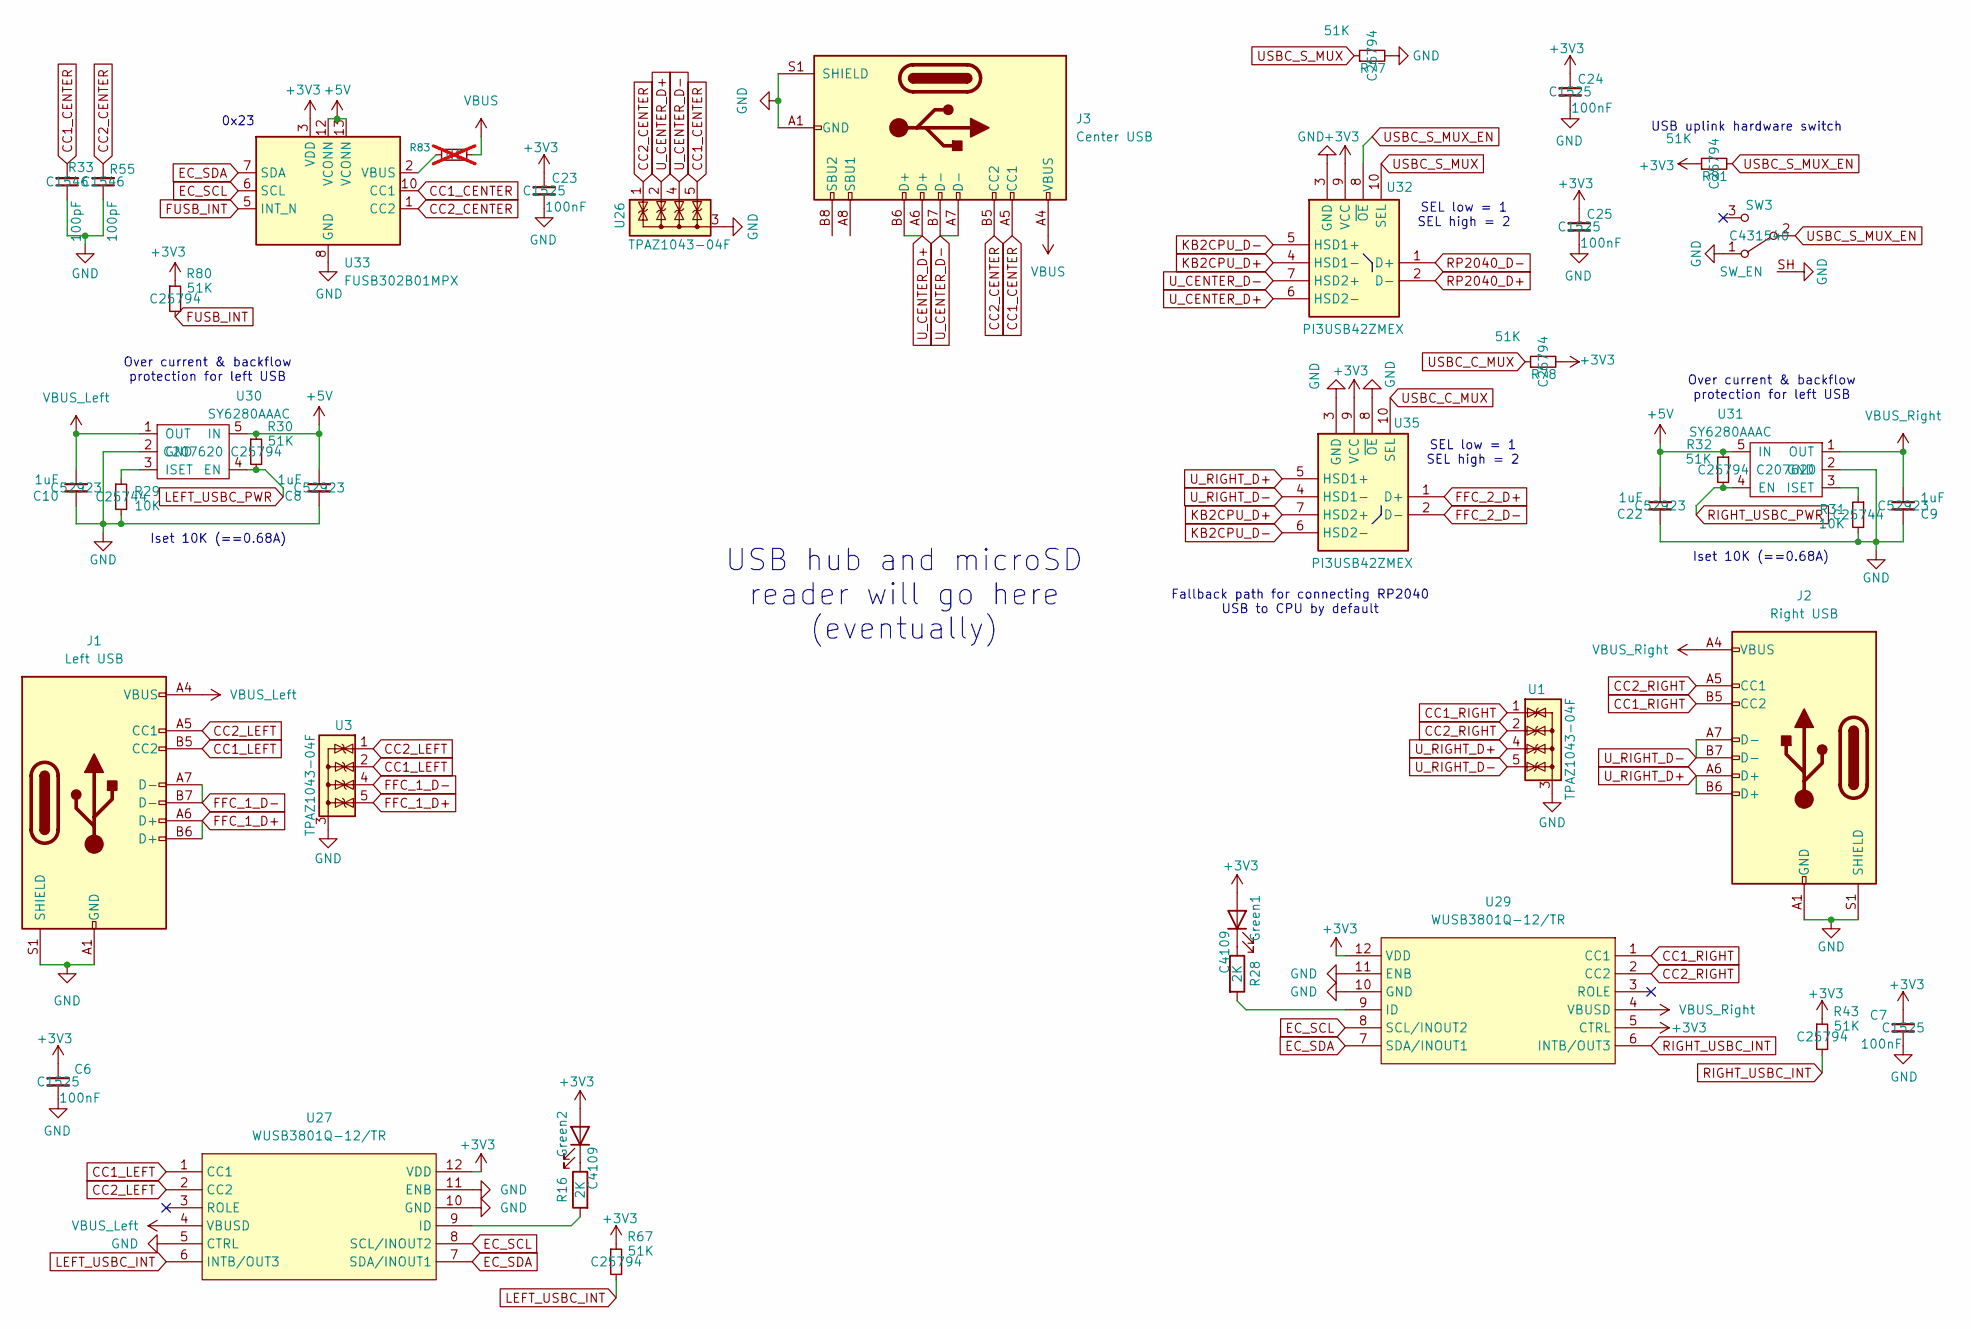
[picture p7: schematic usb.kicad_sch]

Parts:
C6, C7, C23, C24, C25: 100nF; C_0402_1005Metric; LCSC Part C1525
C8, C9, C10, C22: 1uF; C_0402_1005Metric; LCSC Part C52923
Green1, Green2: LED 0603 Green; LED_0603_1608Metric
J1: Left USB; USB-C-TH_MC-710; LCSC Part C3039315
J2: Right USB; USB-C-TH_MC-710; LCSC Part C3039315
J3: Center USB; USB_C_Receptacle_HRO_TYPE-C-31-M-12; LCSC Part C165948
R16, R28: 2K; R_0402_1005Metric; LCSC Part C4109
R29, R31: 10K; R_0402_1005Metric; LCSC Part C25744
R30, R32, R43, R67, R77, R78, R80, R81: 51K; R_0402_1005Metric; LCSC Part C25794
R33, R55: 100pF; R_0402_1005Metric; LCSC Part C1546
R83: NC; R_0402_1005Metric; not fitted
SW3: SW_EN; SW_SPDT_PCM12_SH; LCSC Part C431540
U1, U3, U26: TPAZ1043-04F; USON-10_2.5x1.0mm_P0.5mm
U27, U29: WUSB3801Q-12/TR; X2QFN-12_L1.6-W1.6-P0.40-LS1.2; LCSC Part C2931342
U30, U31: SY6280AAAC; SOT-23-5; LCSC Part C207620
U32, U35: PI3USB42ZMEX; QFN40P140X180X55-10N; Manufacturer_Part_Number FSUSB42UMX; Mouser Part Number 512-FSUSB42UMX
U33: FUSB302B01MPX; WQFN-14-1EP_2.5x2.5mm_P0.5mm_EP1.45x1.45mm

Connections:
+3V3: C6.1, C7.1, C23.1, C24.1, C25.1, Green1.2 (A), Green2.2 (A), R43.1, R67.1, R78.2, R80.1, R81.1, U27.12 (VDD), U29.5 (CTRL), U29.12 (VDD), U32.9 (VCC), U33.3 (VDD), U33.4 (VDD), U35.9 (VCC)
+5V: C8.1, C22.1, R30.1, R32.1, U30.5 (IN), U31.5 (IN), U33.12 (VCONN), U33.13 (VCONN)
CC1_CENTER: J3.A5 (CC1), R33.2, U26.5 (IO4), U26.6 (NC), U33.10 (CC1), U33.11 (CC1)
CC1_LEFT: J1.B5 (CC2), U3.2 (IO2), U3.9 (NC), U27.1 (CC1)
CC1_RIGHT: J2.B5 (CC2), U1.1 (IO1), U1.10 (NC), U29.1 (CC1)
CC2_CENTER: J3.B5 (CC2), R55.2, U26.1 (IO1), U26.10 (NC), U33.1 (CC2), U33.14 (CC2)
CC2_LEFT: J1.A5 (CC1), U3.1 (IO1), U3.10 (NC), U27.2 (CC2)
CC2_RIGHT: J2.A5 (CC1), U1.2 (IO2), U1.9 (NC), U29.2 (CC2)
EC_SCL: U27.8 (SCL/INOUT2), U29.8 (SCL/INOUT2), U33.6 (SCL)
EC_SDA: U27.7 (SDA/INOUT1), U29.7 (SDA/INOUT1), U33.7 (SDA)
FFC_1_D+: J1.A6 (D+), J1.B6 (D+), U3.5 (IO4), U3.6 (NC)
FFC_1_D-: J1.A7 (D-), J1.B7 (D-), U3.4 (IO3), U3.7 (NC)
FFC_2_D+: U35.1 (D+)
FFC_2_D-: U35.2 (D-)
FUSB_INT: R80.2, U33.5 (INT_N)
GND: C6.2, C7.2, C8.2, C9.2, C10.2, C22.2, C23.2, C24.2, C25.2, J1.A1 (GND), J1.A12 (GND), J1.B1 (GND), J1.B12 (GND), J1.S1 (SHIELD), J2.A1 (GND), J2.A12 (GND), J2.B1 (GND), J2.B12 (GND), J2.S1 (SHIELD), J3.A1 (GND), J3.A12 (GND), J3.B1 (GND), J3.B12 (GND), J3.S1 (SHIELD), R29.2, R31.2, R33.1, R55.1, R77.2, SW3.1 (A), SW3.SH, U1.3 (G), U1.8 (G), U3.3 (G), U3.8 (G), U26.3 (G), U26.8 (G), U27.5 (CTRL), U27.10 (GND), U27.11 (ENB), U29.10 (GND), U29.11 (ENB), U30.2 (GND), U31.2 (GND), U32.3 (GND), U33.8 (GND), U33.9 (GND), U33.15 (GND), U35.3 (GND), U35.8 (~OE)
KB2CPU_D+: U32.4 (HSD1-), U35.7 (HSD2+)
KB2CPU_D-: U32.5 (HSD1+), U35.6 (HSD2-)
LEFT_USBC_INT: R67.2, U27.6 (INTB/OUT3)
LEFT_USBC_PWR: R30.2, U30.4 (EN)
unnamed: Green1.1 (K), R28.1
unnamed: Green2.1 (K), R16.1
unnamed: R16.2, U27.9 (ID)
unnamed: R28.2, U29.9 (ID)
unnamed: R29.1, U30.3 (ISET)
unnamed: R31.1, U31.3 (ISET)
unnamed: R83.1, U33.2 (VBUS)
RIGHT_USBC_INT: R43.2, U29.6 (INTB/OUT3)
RIGHT_USBC_PWR: R32.2, U31.4 (EN)
RP2040_D+: U32.2 (D-)
RP2040_D-: U32.1 (D+)
USBC_C_MUX: R78.1, U35.10 (SEL)
USBC_S_MUX: R77.1, U32.10 (SEL)
USBC_S_MUX_EN: R81.2, SW3.2 (B), U32.8 (~OE)
U_CENTER_D+: J3.A6 (D+), J3.B6 (D+), U26.2 (IO2), U26.9 (NC), U32.6 (HSD2-)
U_CENTER_D-: J3.A7 (D-), J3.B7 (D-), U26.4 (IO3), U26.7 (NC), U32.7 (HSD2+)
U_RIGHT_D+: J2.A6 (D+), J2.B6 (D+), U1.4 (IO3), U1.7 (NC), U35.5 (HSD1+)
U_RIGHT_D-: J2.A7 (D-), J2.B7 (D-), U1.5 (IO4), U1.6 (NC), U35.4 (HSD1-)
VBUS: J3.A4 (VBUS), J3.A9 (VBUS), J3.B4 (VBUS), J3.B9 (VBUS), R83.2
VBUS_Left: C10.1, J1.A4 (VBUS), J1.A9 (VBUS), J1.B4 (VBUS), J1.B9 (VBUS), U27.4 (VBUSD), U30.1 (OUT)
VBUS_Right: C9.1, J2.A4 (VBUS), J2.A9 (VBUS), J2.B4 (VBUS), J2.B9 (VBUS), U29.4 (VBUSD), U31.1 (OUT)

Notes on the sheet:
Fallback path for connecting RP2040 USB to CPU by default
Iset 10K (==0.68A)
USB uplink hardware switch
0x23
USB hub and microSD reader will go here (eventually)
Over current & backflow protection for left USB
SEL low = 1 SEL high = 2
