ZeroPhone/ZeroPhoneNext-PCB/top_board_pizero/display.kicad_sch

## KiCad design top_board_pizero/display.kicad_sch (2026-03-20)

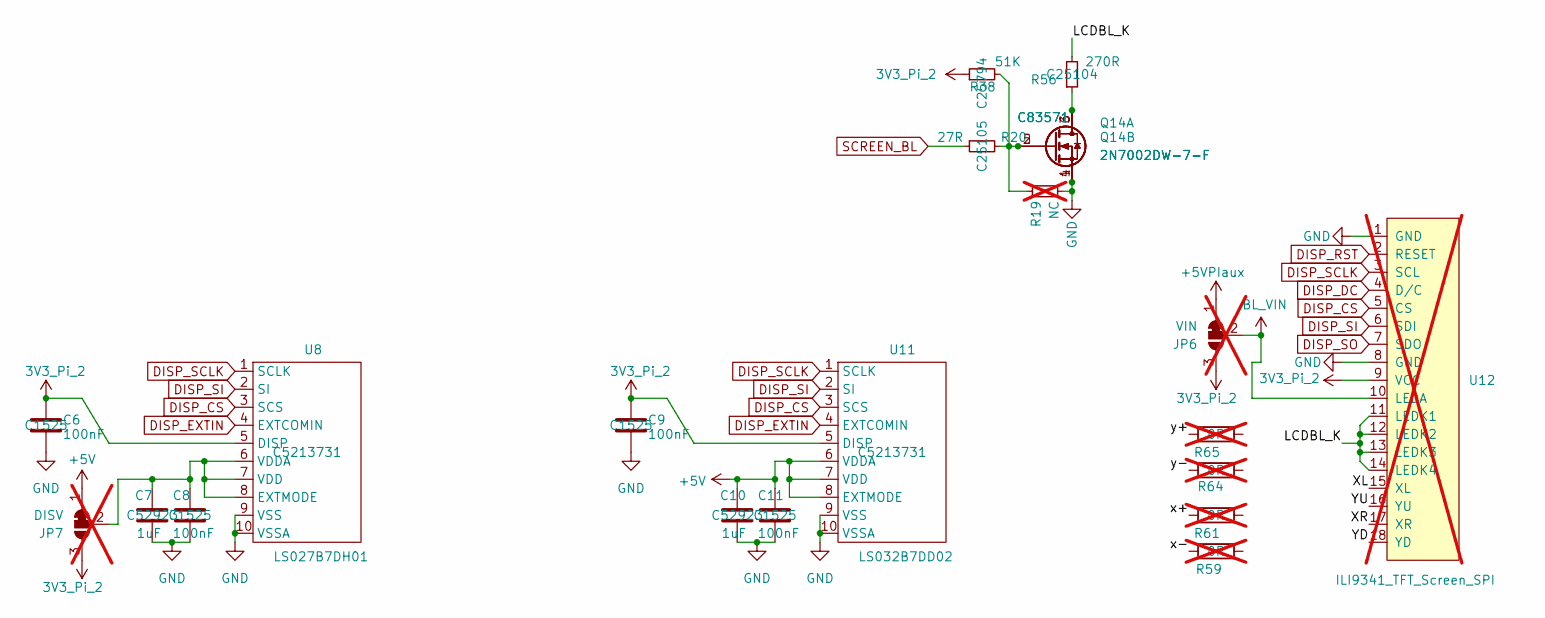
[picture p8: schematic display.kicad_sch]

Parts:
C6, C8, C9, C11: 100nF; C_0402_1005Metric; LCSC Part C1525
C7, C10: 1uF; C_0402_1005Metric; LCSC Part C52923
JP6: VIN; SolderJumper-3_P1.3mm_Bridged12_RoundedPad1.0x1.5mm; not fitted
JP7: DISV; SolderJumper-3_P1.3mm_Bridged12_RoundedPad1.0x1.5mm; not fitted
Q14: 2N7002DW-7-F; SOT-363_SC-70-6; LCSC Part C83571
R19: NC; R_0402_1005Metric; not fitted
R20: 27R; R_0402_1005Metric; LCSC Part C25105
R38: 51K; R_0402_1005Metric; LCSC Part C25794
R56: 270R; R_0402_1005Metric; LCSC Part C25104
R59, R61, R64, R65: 0R; R_0603_1608Metric_Jumper; not fitted
U8: LS027B7DH01; HRS_FH34SRJ-10S-0.5SH(50); LCSC Part C5213731
U11: LS032B7DD02; HRS_FH34SRJ-10S-0.5SH(50); LCSC Part C5213731
U12: ILI9341_TFT_Screen_SPI; ILI9341_SCREEN_2.4INCH_SPI; not fitted

Connections:
3V3_Pi_2: C6.1, C9.1, JP6.3 (B), JP7.3 (B), R38.1, U8.5 (DISP), U11.5 (DISP), U12.9 (VCC)
+5V: C10.1, C11.1, JP7.1 (A), U11.6 (VDDA), U11.7 (VDD), U11.8 (EXTMODE)
+5VPIaux: JP6.1 (A)
BL_VIN: JP6.2 (C), U12.10 (LEDA)
DISP_CS: U8.3 (SCS), U11.3 (SCS), U12.5 (CS)
DISP_DC: U12.4 (D/C)
DISP_EXTIN: U8.4 (EXTCOMIN), U11.4 (EXTCOMIN)
DISP_RST: U12.2 (RESET)
DISP_SCLK: U8.1 (SCLK), U11.1 (SCLK), U12.3 (SCL)
DISP_SI: U8.2 (SI), U11.2 (SI), U12.6 (SDI)
DISP_SO: U12.7 (SDO)
GND: C6.2, C7.2, C8.2, C9.2, C10.2, C11.2, Q14.1 (S), Q14.4 (S), R19.1, U8.9 (VSS), U8.10 (VSSA), U11.9 (VSS), U11.10 (VSSA), U12.1 (GND), U12.8 (GND)
LCDBL_K: R56.2, U12.11 (LEDK1), U12.12 (LEDK2), U12.13 (LEDK3), U12.14 (LEDK4)
unnamed: C7.1, C8.1, JP7.2 (C), U8.6 (VDDA), U8.7 (VDD), U8.8 (EXTMODE)
unnamed: Q14.2 (G), Q14.5 (G), R19.2, R20.2, R38.2
unnamed: Q14.3 (D), Q14.6 (D), R56.1
SCREEN_BL: R20.1
XL: U12.15 (XL)
XR: U12.17 (XR)
YD: U12.18 (YD)
YU: U12.16 (YU)
x+: R61.1
x-: R59.2
y+: R65.1
y-: R64.2
