ZeroPhone/ZeroPhoneNext-PCB/top_board_pizero/expansion.kicad_sch

## KiCad design top_board_pizero/expansion.kicad_sch (2026-03-20)

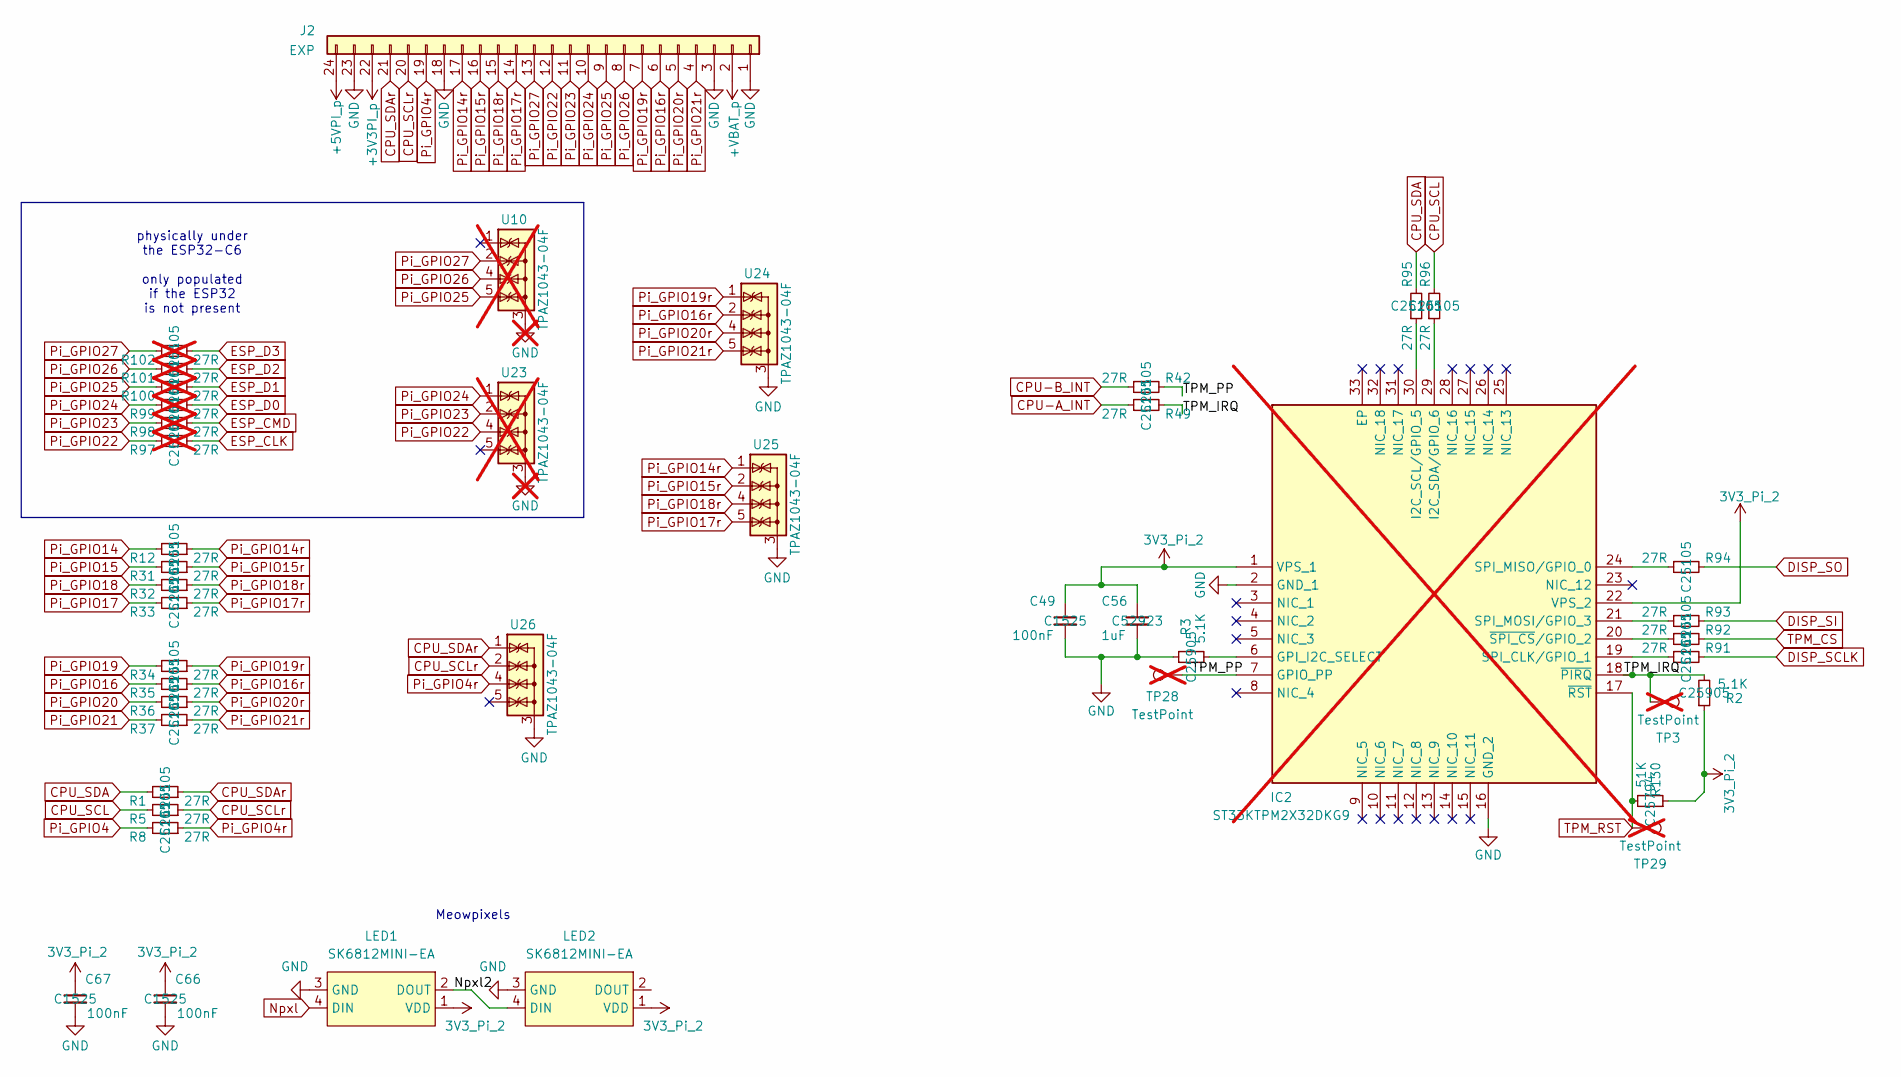
[picture p9: schematic expansion.kicad_sch]

Parts:
C49, C66, C67: 100nF; C_0402_1005Metric; LCSC Part C1525
C56: 1uF; C_0402_1005Metric; LCSC Part C52923
IC2: ST33KTPM2X32DKG9; QFN-32-1EP_5x5mm_P0.5mm_EP3.1x3.1mm; Manufacturer_Part_Number ST33KTPM2X32DKG9; not fitted
J2: EXP; PinSocket_1x24_P2.54mm_Horizontal_SMD
LED1, LED2: SK6812MINI-EA; LED-SMD_4P-L3.2-W2.8_SK6812MINI-EA; LCSC Part C5378731
R1, R5, R8, R12, R31, R32, R33, R34, R35, R36, R37, R42, R49, R91, R92, R93, R94, R95, R96: 27R; R_0402_1005Metric; LCSC Part C25105
R2, R3: 5.1K; R_0402_1005Metric; LCSC Part C25905
R97, R98, R99, R100, R101, R102: 27R; R_0402_1005Metric; LCSC Part C25105; not fitted
R130: 51K; R_0402_1005Metric; LCSC Part C25794
TP3, TP28, TP29: TestPoint; TestPoint_Pad_D1.0mm; not fitted
U10, U23: TPAZ1043-04F; USON-10_2.5x1.0mm_P0.5mm; not fitted
U24, U25, U26: TPAZ1043-04F; USON-10_2.5x1.0mm_P0.5mm

Connections:
3V3_Pi_2: C49.1, C56.1, C66.1, C67.1, IC2.1 (VPS_1), IC2.22 (VPS_2), LED1.1 (VDD), LED2.1 (VDD), R2.1, R130.1
+3V3PI_p: J2.22
+5VPI_p: J2.24
+VBAT_p: J2.2
CPU-A_INT: R49.1
CPU-B_INT: R42.1
CPU_SCL: R5.2, R96.2
CPU_SCLr: J2.20, R5.1, U26.2 (IO2), U26.9 (NC)
CPU_SDA: R1.2, R95.2
CPU_SDAr: J2.21, R1.1, U26.1 (IO1), U26.10 (NC)
DISP_SCLK: R91.2
DISP_SI: R93.2
DISP_SO: R94.2
ESP_CLK: R97.1
ESP_CMD: R98.1
ESP_D0: R99.1
ESP_D1: R100.1
ESP_D2: R101.1
ESP_D3: R102.1
GND: C49.2, C56.2, C66.2, C67.2, IC2.2 (GND_1), IC2.16 (GND_2), J2.1, J2.3, J2.18, J2.23, LED1.3 (GND), LED2.3 (GND), R3.1, U10.3 (G), U10.8 (G), U23.3 (G), U23.8 (G), U24.3 (G), U24.8 (G), U25.3 (G), U25.8 (G), U26.3 (G), U26.8 (G)
unnamed: IC2.6 (GPI_I2C_SELECT), R3.2
unnamed: IC2.19 (SPI_CLK/GPIO_1), R91.1
unnamed: IC2.20 (~SPI_CS/GPIO_2), R92.1
unnamed: IC2.21 (SPI_MOSI/GPIO_3), R93.1
unnamed: IC2.24 (SPI_MISO/GPIO_0), R94.1
unnamed: IC2.29 (I2C_SDA/GPIO_6), R96.1
unnamed: IC2.30 (I2C_SCL/GPIO_5), R95.1
unnamed: U10.1 (IO1), U10.10 (NC)
unnamed: U23.5 (IO4), U23.6 (NC)
unnamed: U26.5 (IO4), U26.6 (NC)
Npxl: LED1.4 (DIN)
Npxl2: LED1.2 (DOUT), LED2.4 (DIN)
Pi_GPIO4: R8.2
Pi_GPIO4r: J2.19, R8.1, U26.4 (IO3), U26.7 (NC)
Pi_GPIO14: R12.2
Pi_GPIO14r: J2.17, R12.1, U25.1 (IO1), U25.10 (NC)
Pi_GPIO15: R31.2
Pi_GPIO15r: J2.16, R31.1, U25.2 (IO2), U25.9 (NC)
Pi_GPIO16: R35.2
Pi_GPIO16r: J2.6, R35.1, U24.2 (IO2), U24.9 (NC)
Pi_GPIO17: R33.2
Pi_GPIO17r: J2.14, R33.1, U25.5 (IO4), U25.6 (NC)
Pi_GPIO18: R32.2
Pi_GPIO18r: J2.15, R32.1, U25.4 (IO3), U25.7 (NC)
Pi_GPIO19: R34.2
Pi_GPIO19r: J2.7, R34.1, U24.1 (IO1), U24.10 (NC)
Pi_GPIO20: R36.2
Pi_GPIO20r: J2.5, R36.1, U24.4 (IO3), U24.7 (NC)
Pi_GPIO21: R37.2
Pi_GPIO21r: J2.4, R37.1, U24.5 (IO4), U24.6 (NC)
Pi_GPIO22: J2.12, R97.2, U23.4 (IO3), U23.7 (NC)
Pi_GPIO23: J2.11, R98.2, U23.2 (IO2), U23.9 (NC)
Pi_GPIO24: J2.10, R99.2, U23.1 (IO1), U23.10 (NC)
Pi_GPIO25: J2.9, R100.2, U10.5 (IO4), U10.6 (NC)
Pi_GPIO26: J2.8, R101.2, U10.4 (IO3), U10.7 (NC)
Pi_GPIO27: J2.13, R102.2, U10.2 (IO2), U10.9 (NC)
TPM_CS: R92.2
TPM_IRQ: IC2.18 (~PIRQ), R2.2, R49.2, TP3.1
TPM_PP: IC2.7 (GPIO_PP), R42.2, TP28.1
TPM_RST: IC2.17 (~RST), R130.2, TP29.1

Notes on the sheet:
physically under the ESP32-C6 only populated if the ESP32 is not present
Meowpixels
