ZeroPhone/ZeroPhoneNext-PCB/top_board_pizero/modem.kicad_sch

## KiCad design top_board_pizero/modem.kicad_sch (2026-03-20)

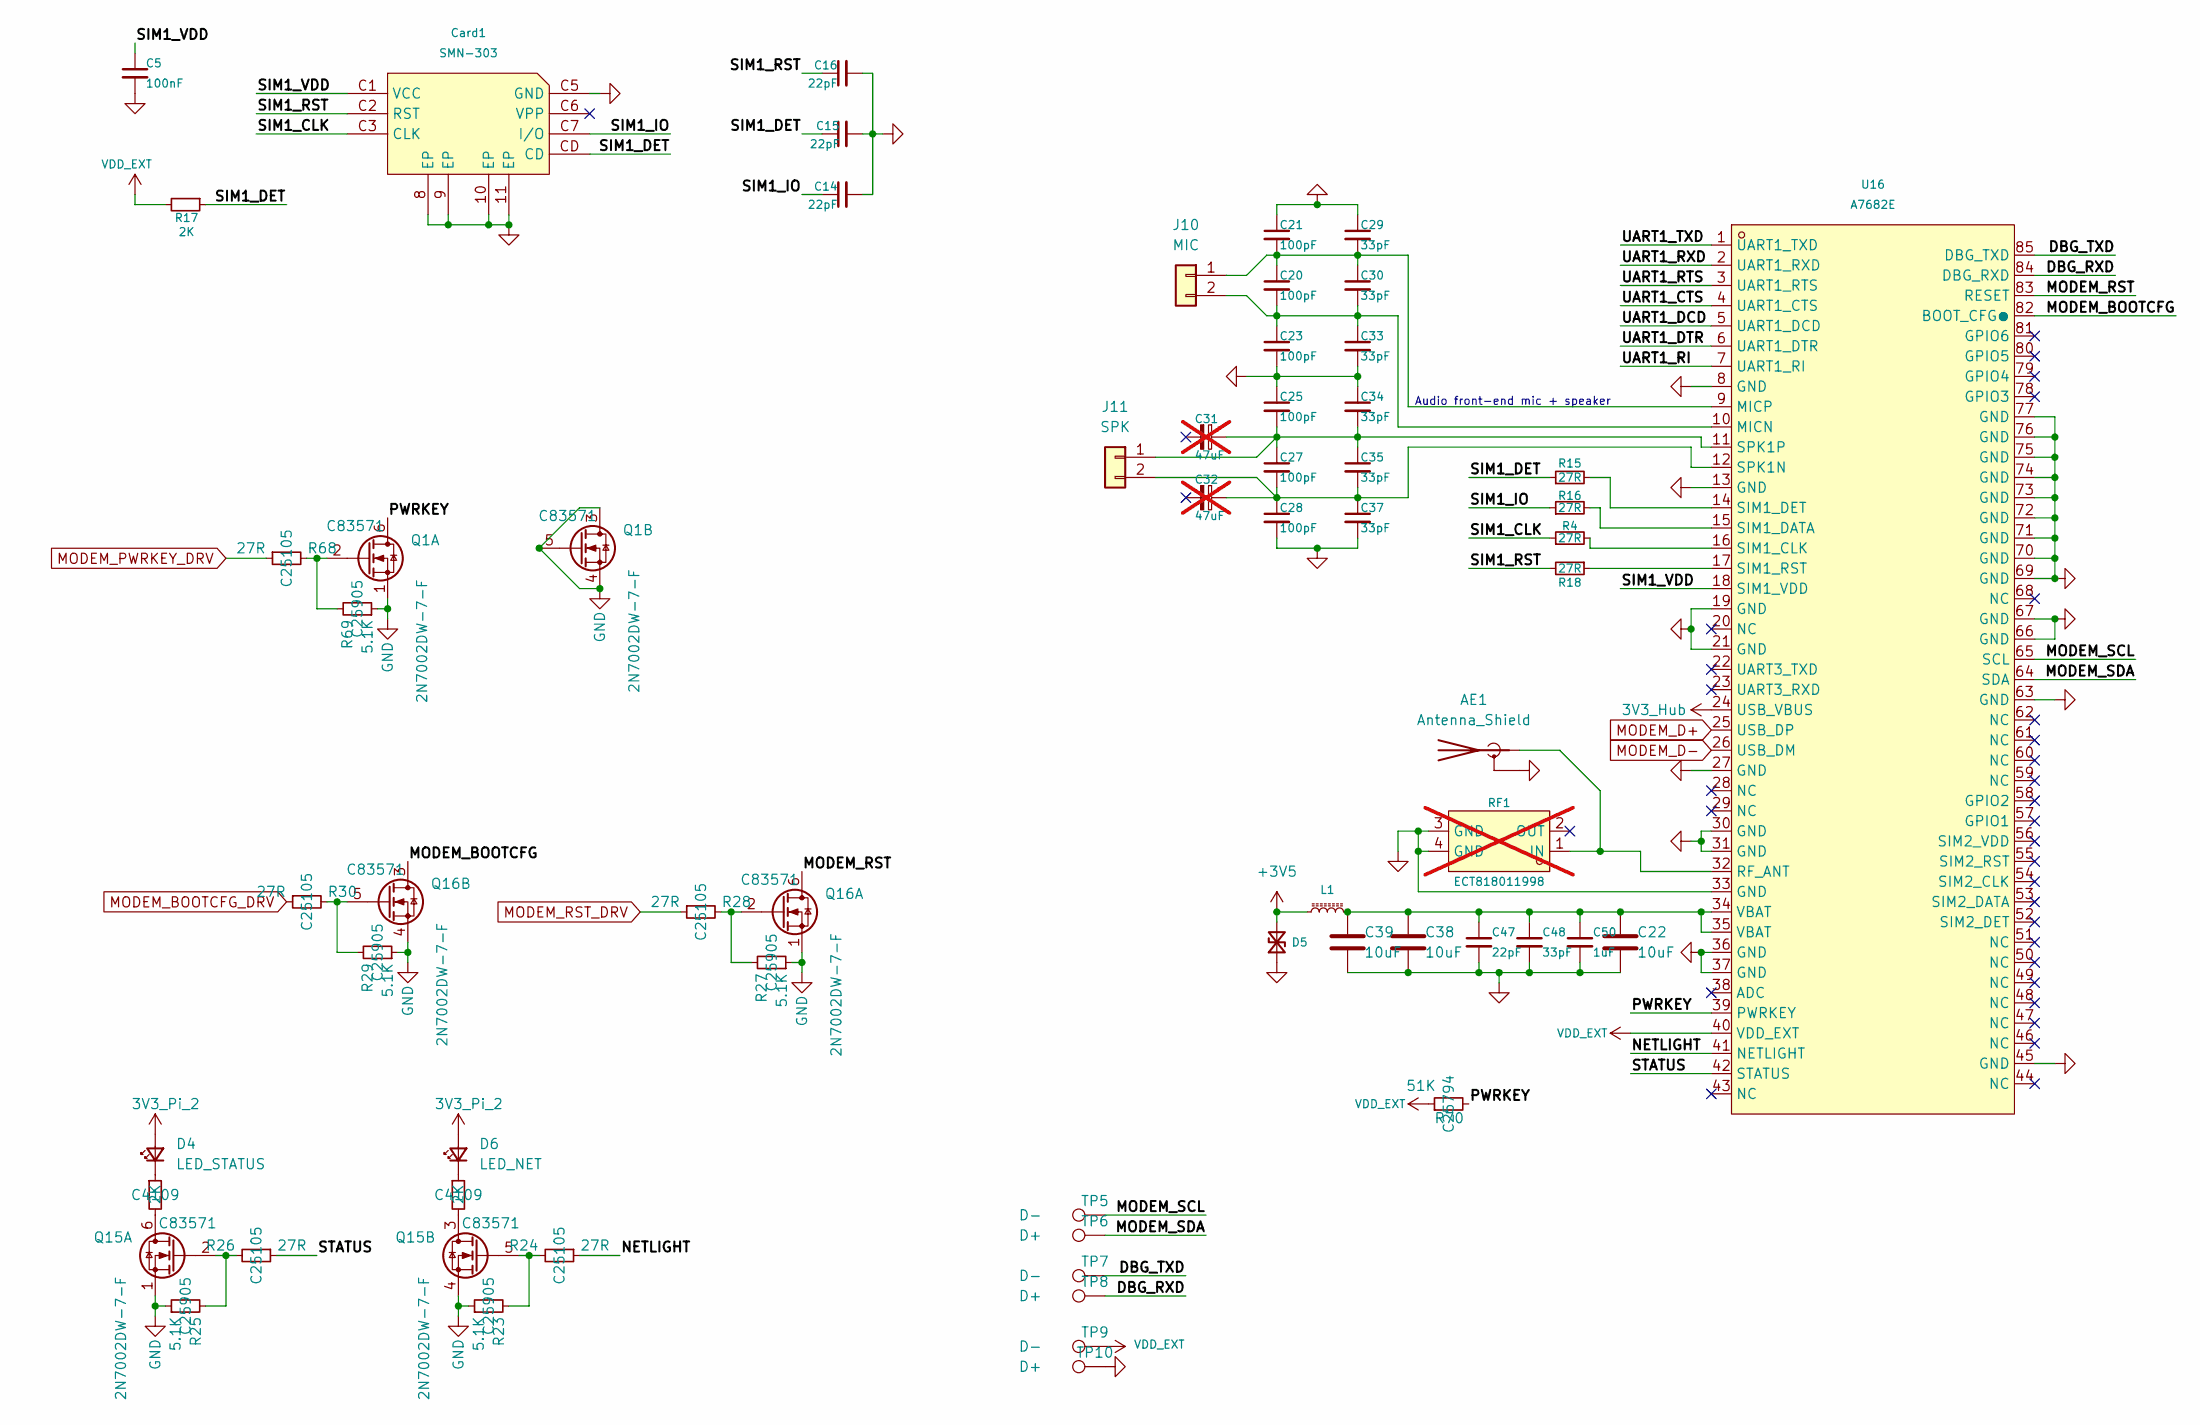
[picture p10: schematic modem.kicad_sch]

Parts:
AE1: Antenna_Shield; U.FL_Molex_MCRF_73412-0110_Vertical
C5: 100nF; C_0402_1005Metric; LCSC Part C1525
C14, C15, C16, C47: 22pF; C_0402_1005Metric; LCSC Part C1555
C20, C21, C23, C25, C27, C28: 100pF; C_0402_1005Metric; LCSC Part C1546
C22, C38, C39: 10uF; C_0805_2012Metric_Pad1.18x1.45mm_HandSolder
C29, C30, C33, C34, C35, C37, C48: 33pF; C_0402_1005Metric; LCSC Part C1562
C31, C32: 47uF; CP_Elec_4x3.9; not fitted
C50: 1uF; C_0402_1005Metric; LCSC Part C52923
Card1: SMN-303; SIM-SMD_SMN-303; LCSC Part C266888
D4: LED_STATUS; LED_0603_1608Metric
D5: D_TVS_Small; D_0402_1005Metric_Pad0.77x0.64mm_HandSolder; LCSC Part C2441614
D6: LED_NET; LED_0603_1608Metric
J10: MIC; MICROPHONE
J11: SPK; PinHeader_1x02_P1.27mm_Vertical
L1: 30Ω@100MHz 1 Line Ferrite Bead 0805 4A 14mΩ; L_0805_2012Metric; lcsc_id C16903
Q1, Q15, Q16: 2N7002DW-7-F; SOT-363_SC-70-6; LCSC Part C83571
R4, R15, R16, R18, R24, R26, R28, R30, R68: 27R; R_0402_1005Metric; LCSC Part C25105
R17, R117, R118: 2K; R_0402_1005Metric; LCSC Part C4109
R23, R25, R27, R29, R69: 5.1K; R_0402_1005Metric; LCSC Part C25905
R70: 51K; R_0402_1005Metric; LCSC Part C25794
RF1: ECT818011998; IPEX-SMD_ECT818011998; LCSC Part C437250; not fitted
TP5, TP7, TP9: D-; TestPoint_Pad_1.0x1.0mm
TP6, TP8, TP10: D+; TestPoint_Pad_1.0x1.0mm
U16: A7682E; COMM-SMD_A7682E; LCSC Part C5362858

Connections:
3V3_Hub: U16.24 (USB_VBUS)
3V3_Pi_2: D4.2 (A), D6.2 (A)
+3V5: D5.2 (A2), L1.1
DBG_RXD: TP8.1, U16.84 (DBG_RXD)
DBG_TXD: TP7.1, U16.85 (DBG_TXD)
GND: AE1.2 (Shield), C5.2, C14.2, C15.2, C16.2, C21.1, C22.1, C23.2, C25.1, C28.2, C29.1, C33.2, C34.1, C37.2, C38.1, C39.1, C47.2, C48.2, C50.2, Card1.8 (EP), Card1.9 (EP), Card1.10 (EP), Card1.11 (EP), Card1.C5 (GND), D5.1 (A1), Q1.1 (S), Q1.3 (D), Q1.4 (S), Q1.5 (G), Q15.1 (S), Q15.4 (S), Q16.1 (S), Q16.4 (S), R23.1, R25.1, R27.1, R29.1, R69.1, RF1.3 (GND), RF1.4 (GND), TP10.1, U16.8 (GND), U16.13 (GND), U16.19 (GND), U16.21 (GND), U16.27 (GND), U16.30 (GND), U16.31 (GND), U16.33 (GND), U16.36 (GND), U16.37 (GND), U16.45 (GND), U16.63 (GND), U16.66 (GND), U16.67 (GND), U16.69 (GND), U16.70 (GND), U16.71 (GND), U16.72 (GND), U16.73 (GND), U16.74 (GND), U16.75 (GND), U16.76 (GND), U16.77 (GND)
MODEM_BOOTCFG: Q16.3 (D), U16.82 (BOOT_CFG●)
MODEM_BOOTCFG_DRV: R30.1
MODEM_D+: U16.25 (USB_DP)
MODEM_D-: U16.26 (USB_DM)
MODEM_PWRKEY_DRV: R68.1
MODEM_RST: Q16.6 (D), U16.83 (RESET)
MODEM_RST_DRV: R28.1
MODEM_SCL: TP5.1, U16.65 (SCL)
MODEM_SDA: TP6.1, U16.64 (SDA)
NETLIGHT: R24.1, U16.41 (NETLIGHT)
unnamed: AE1.1 (A), RF1.1 (IN), U16.32 (RF_ANT)
unnamed: C20.1, C21.2, C29.2, C30.1, J10.1, U16.9 (MICP)
unnamed: C20.2, C23.1, C30.2, C33.1, J10.2, U16.10 (MICN)
unnamed: C22.2, C38.2, C39.2, C47.1, C48.1, C50.1, L1.2, U16.34 (VBAT), U16.35 (VBAT)
unnamed: C25.2, C27.1, C31.1, C34.2, C35.1, J11.1, U16.11 (SPK1P)
unnamed: C27.2, C28.1, C32.1, C35.2, C37.1, J11.2, U16.12 (SPK1N)
unnamed: D4.1 (K), R117.1
unnamed: D6.1 (K), R118.1
unnamed: Q1.2 (G), R68.2, R69.2
unnamed: Q15.2 (G), R25.2, R26.2
unnamed: Q15.3 (D), R118.2
unnamed: Q15.5 (G), R23.2, R24.2
unnamed: Q15.6 (D), R117.2
unnamed: Q16.2 (G), R27.2, R28.2
unnamed: Q16.5 (G), R29.2, R30.2
unnamed: R4.2, U16.16 (SIM1_CLK)
unnamed: R15.2, U16.14 (SIM1_DET)
unnamed: R16.2, U16.15 (SIM1_DATA)
unnamed: R18.1, U16.17 (SIM1_RST)
PWRKEY: Q1.6 (D), R70.2, U16.39 (PWRKEY)
SIM1_CLK: Card1.C3 (CLK), R4.1
SIM1_DET: C15.1, Card1.CD, R15.1, R17.1
SIM1_IO: C14.1, Card1.C7 (I/O), R16.1
SIM1_RST: C16.1, Card1.C2 (RST), R18.2
SIM1_VDD: C5.1, Card1.C1 (VCC), U16.18 (SIM1_VDD)
STATUS: R26.1, U16.42 (STATUS)
UART1_CTS: U16.4 (UART1_CTS)
UART1_DCD: U16.5 (UART1_DCD)
UART1_DTR: U16.6 (UART1_DTR)
UART1_RI: U16.7 (UART1_RI)
UART1_RTS: U16.3 (UART1_RTS)
UART1_RXD: U16.2 (UART1_RXD)
UART1_TXD: U16.1 (UART1_TXD)
VDD_EXT: R17.2, R70.1, TP9.1, U16.40 (VDD_EXT)

Notes on the sheet:
Audio front-end mic + speaker
