ZeroPhone/ZeroPhoneNext-PCB/top_board_pizero/power.kicad_sch

## KiCad design top_board_pizero/power.kicad_sch (2026-03-20)

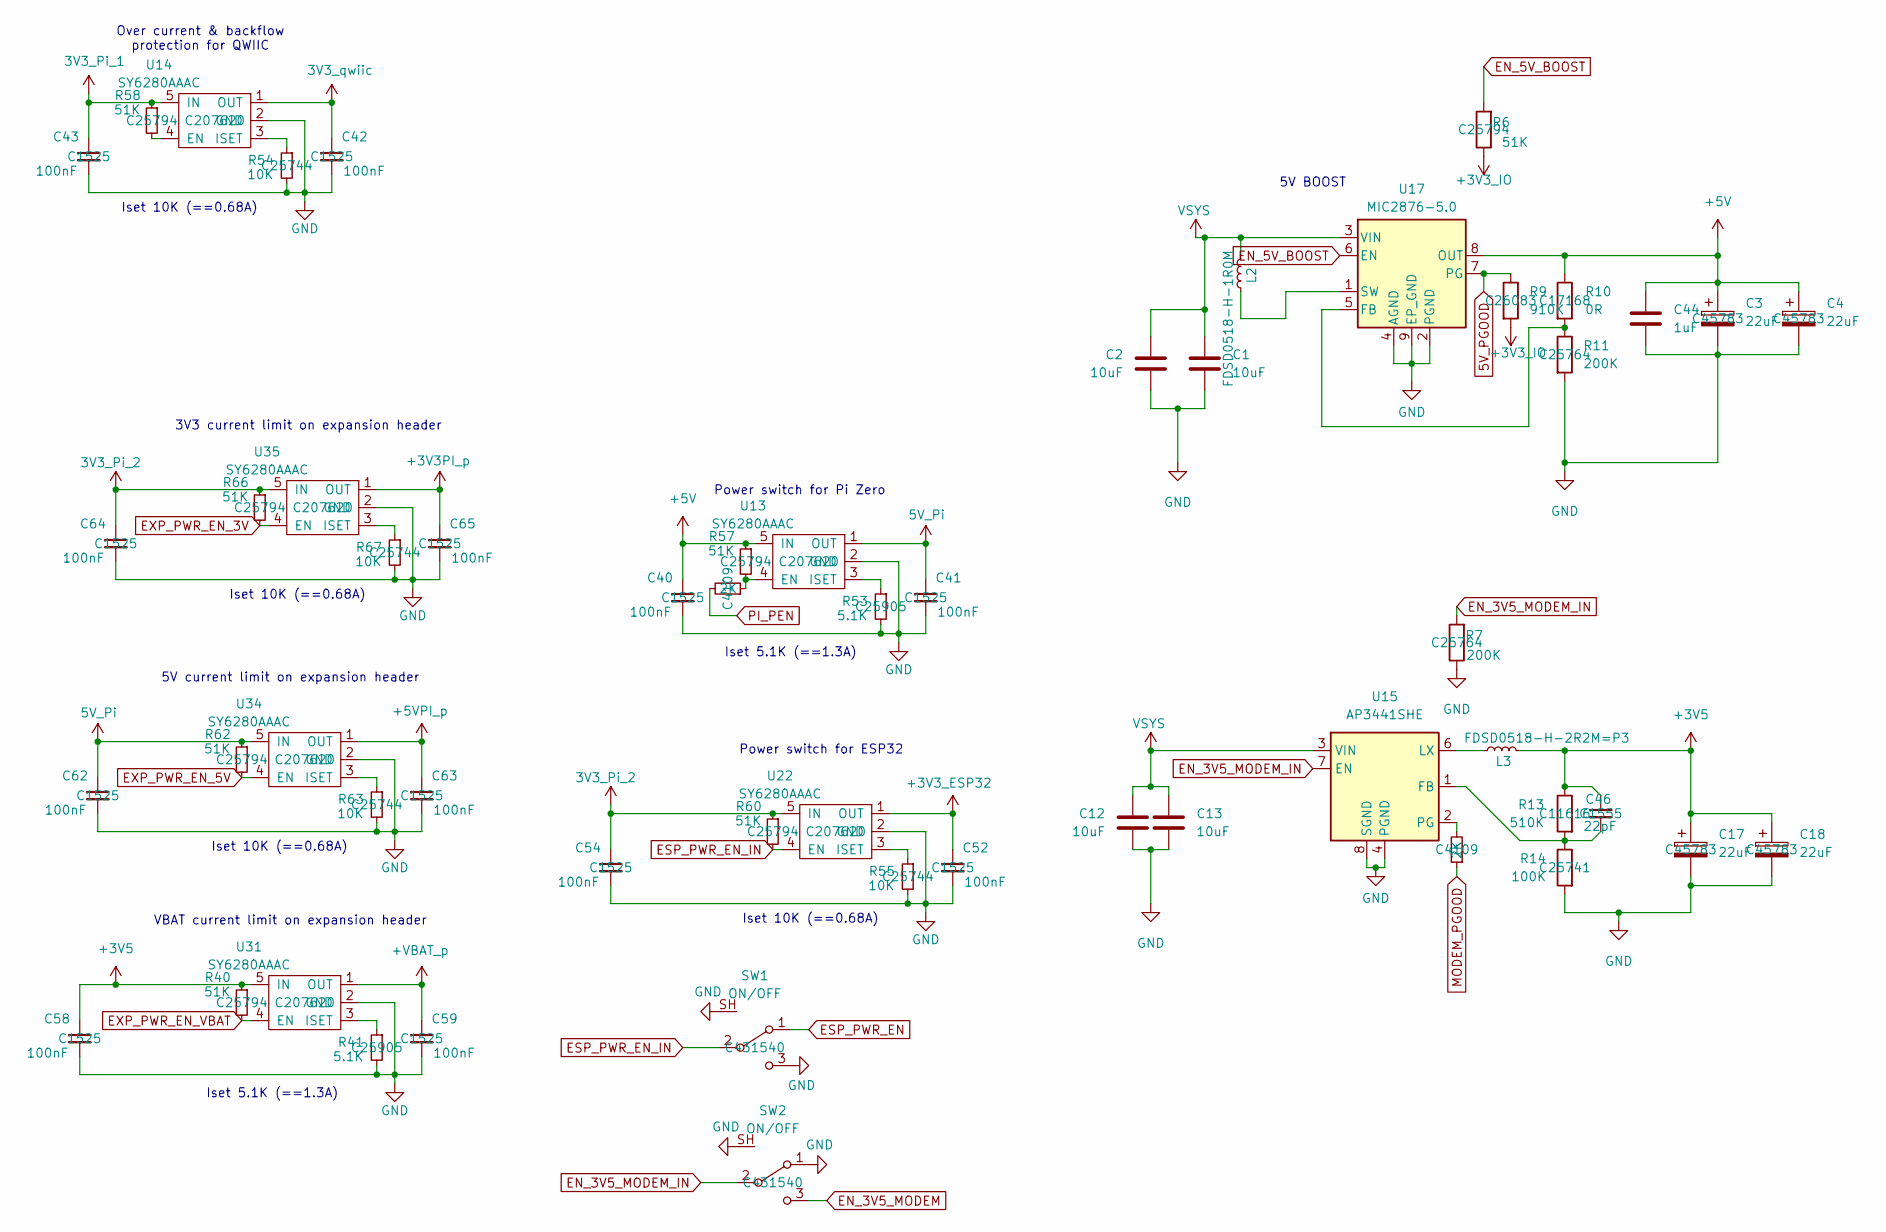
[picture p11: schematic power.kicad_sch]

Parts:
C1, C2, C12, C13: 10uF; C_0805_2012Metric_Pad1.18x1.45mm_HandSolder
C3, C4, C17, C18: 22uF; C_0805_2012Metric_Pad1.18x1.45mm_HandSolder; LCSC Part C45783
C40, C41, C42, C43, C52, C54, C58, C59, C62, C63, C64, C65: 100nF; C_0402_1005Metric; LCSC Part C1525
C44: 1uF; C_0805_2012Metric_Pad1.18x1.45mm_HandSolder
C46: 22pF; C_0402_1005Metric; LCSC Part C1555
L2: FDSD0518-H-1R0M; L_Murata_FDSD0518; LCSC Part C2931055
L3: FDSD0518-H-2R2M=P3; L_Murata_FDSD0518; LCSC Part C3222789
R6, R40, R57, R58, R60, R62, R66: 51K; R_0402_1005Metric; LCSC Part C25794
R7, R11: 200K; R_0402_1005Metric; LCSC Part C25764
R9: 910K; R_0402_1005Metric; LCSC Part C26083
R10: 0R; R_0402_1005Metric; LCSC Part C17168
R13: 510K; R_0402_1005Metric; LCSC Part C11616
R14: 100K; R_0402_1005Metric; LCSC Part C25741
R41, R53: 5.1K; R_0402_1005Metric; LCSC Part C25905
R54, R55, R63, R67: 10K; R_0402_1005Metric; LCSC Part C25744
R115, R116: 2K; R_0402_1005Metric; LCSC Part C4109
SW1, SW2: ON/OFF; SW_SPDT_PCM12_SH; LCSC Part C431540
U13, U14, U22, U31, U34, U35: SY6280AAAC; SOT-23-5; LCSC Part C207620
U15: AP3441SHE; DFN-8-1EP_2x2mm_P0.5mm_EP0.9x1.7mm
U17: MIC2876-5.0; DFN-8-1EP_2x2mm_P0.5mm_EP0.6x1.2mm

Connections:
3V3_Pi_1: C43.1, R58.1, U14.5 (IN)
3V3_Pi_2: C54.1, C64.1, R60.1, R66.1, U22.5 (IN), U35.5 (IN)
3V3_qwiic: C42.1, U14.1 (OUT)
5V_PGOOD: R9.1, U17.7 (PG)
5V_Pi: C41.1, C62.1, R62.1, U13.1 (OUT), U34.5 (IN)
+3V3PI_p: C65.1, U35.1 (OUT)
+3V3_ESP32: C52.1, U22.1 (OUT)
+3V3_IO: R6.1, R9.2
+3V5: C17.1, C18.1, C46.1, C58.1, L3.1, R13.1, R40.1, U31.5 (IN)
+5V: C3.1, C4.1, C40.1, C44.1, R10.1, R57.1, U13.5 (IN), U17.8 (OUT)
+5VPI_p: C63.1, U34.1 (OUT)
+VBAT_p: C59.1, U31.1 (OUT)
EN_3V5_MODEM: SW2.3 (C)
EN_3V5_MODEM_IN: R7.2, SW2.2 (B), U15.7 (EN)
EN_5V_BOOST: R6.2, U17.6 (EN)
ESP_PWR_EN: SW1.1 (A)
ESP_PWR_EN_IN: R60.2, SW1.2 (B), U22.4 (EN)
EXP_PWR_EN_3V: R66.2, U35.4 (EN)
EXP_PWR_EN_5V: R62.2, U34.4 (EN)
EXP_PWR_EN_VBAT: R40.2, U31.4 (EN)
GND: C1.1, C2.1, C3.2, C4.2, C12.1, C13.1, C17.2, C18.2, C40.2, C41.2, C42.2, C43.2, C44.2, C52.2, C54.2, C58.2, C59.2, C62.2, C63.2, C64.2, C65.2, R7.1, R11.2, R14.2, R41.2, R53.2, R54.2, R55.2, R63.2, R67.2, SW1.3 (C), SW1.SH, SW2.1 (A), SW2.SH, U13.2 (GND), U14.2 (GND), U15.4 (PGND), U15.8 (SGND), U15.9 (SGND), U17.2 (PGND), U17.4 (AGND), U17.9 (EP_GND), U22.2 (GND), U31.2 (GND), U34.2 (GND), U35.2 (GND)
MODEM_PGOOD: R116.1
unnamed: C46.2, R13.2, R14.1, U15.1 (FB)
unnamed: L2.1, U17.1 (SW)
unnamed: L3.2, U15.6 (LX)
unnamed: R10.2, R11.1, U17.5 (FB)
unnamed: R41.1, U31.3 (ISET)
unnamed: R53.1, U13.3 (ISET)
unnamed: R54.1, U14.3 (ISET)
unnamed: R55.1, U22.3 (ISET)
unnamed: R58.2, U14.4 (EN)
unnamed: R63.1, U34.3 (ISET)
unnamed: R67.1, U35.3 (ISET)
unnamed: R57.2, R115.1, U13.4 (EN)
unnamed: R116.2, U15.2 (PG)
PI_PEN: R115.2
VSYS: C1.2, C2.2, C12.2, C13.2, L2.2, U15.3 (VIN), U17.3 (VIN)

Notes on the sheet:
5V BOOST
Iset 10K (==0.68A)
5V current limit on expansion header
Power switch for Pi Zero
Over current & backflow protection for QWIIC
Power switch for ESP32
Iset 5.1K (==1.3A)
VBAT current limit on expansion header
3V3 current limit on expansion header
