ZeroPhone/ZeroPhoneNext-PCB/top_board_pizero/top_board_pizero.kicad_sch

## KiCad design top_board_pizero/top_board_pizero.kicad_sch (2026-03-30)

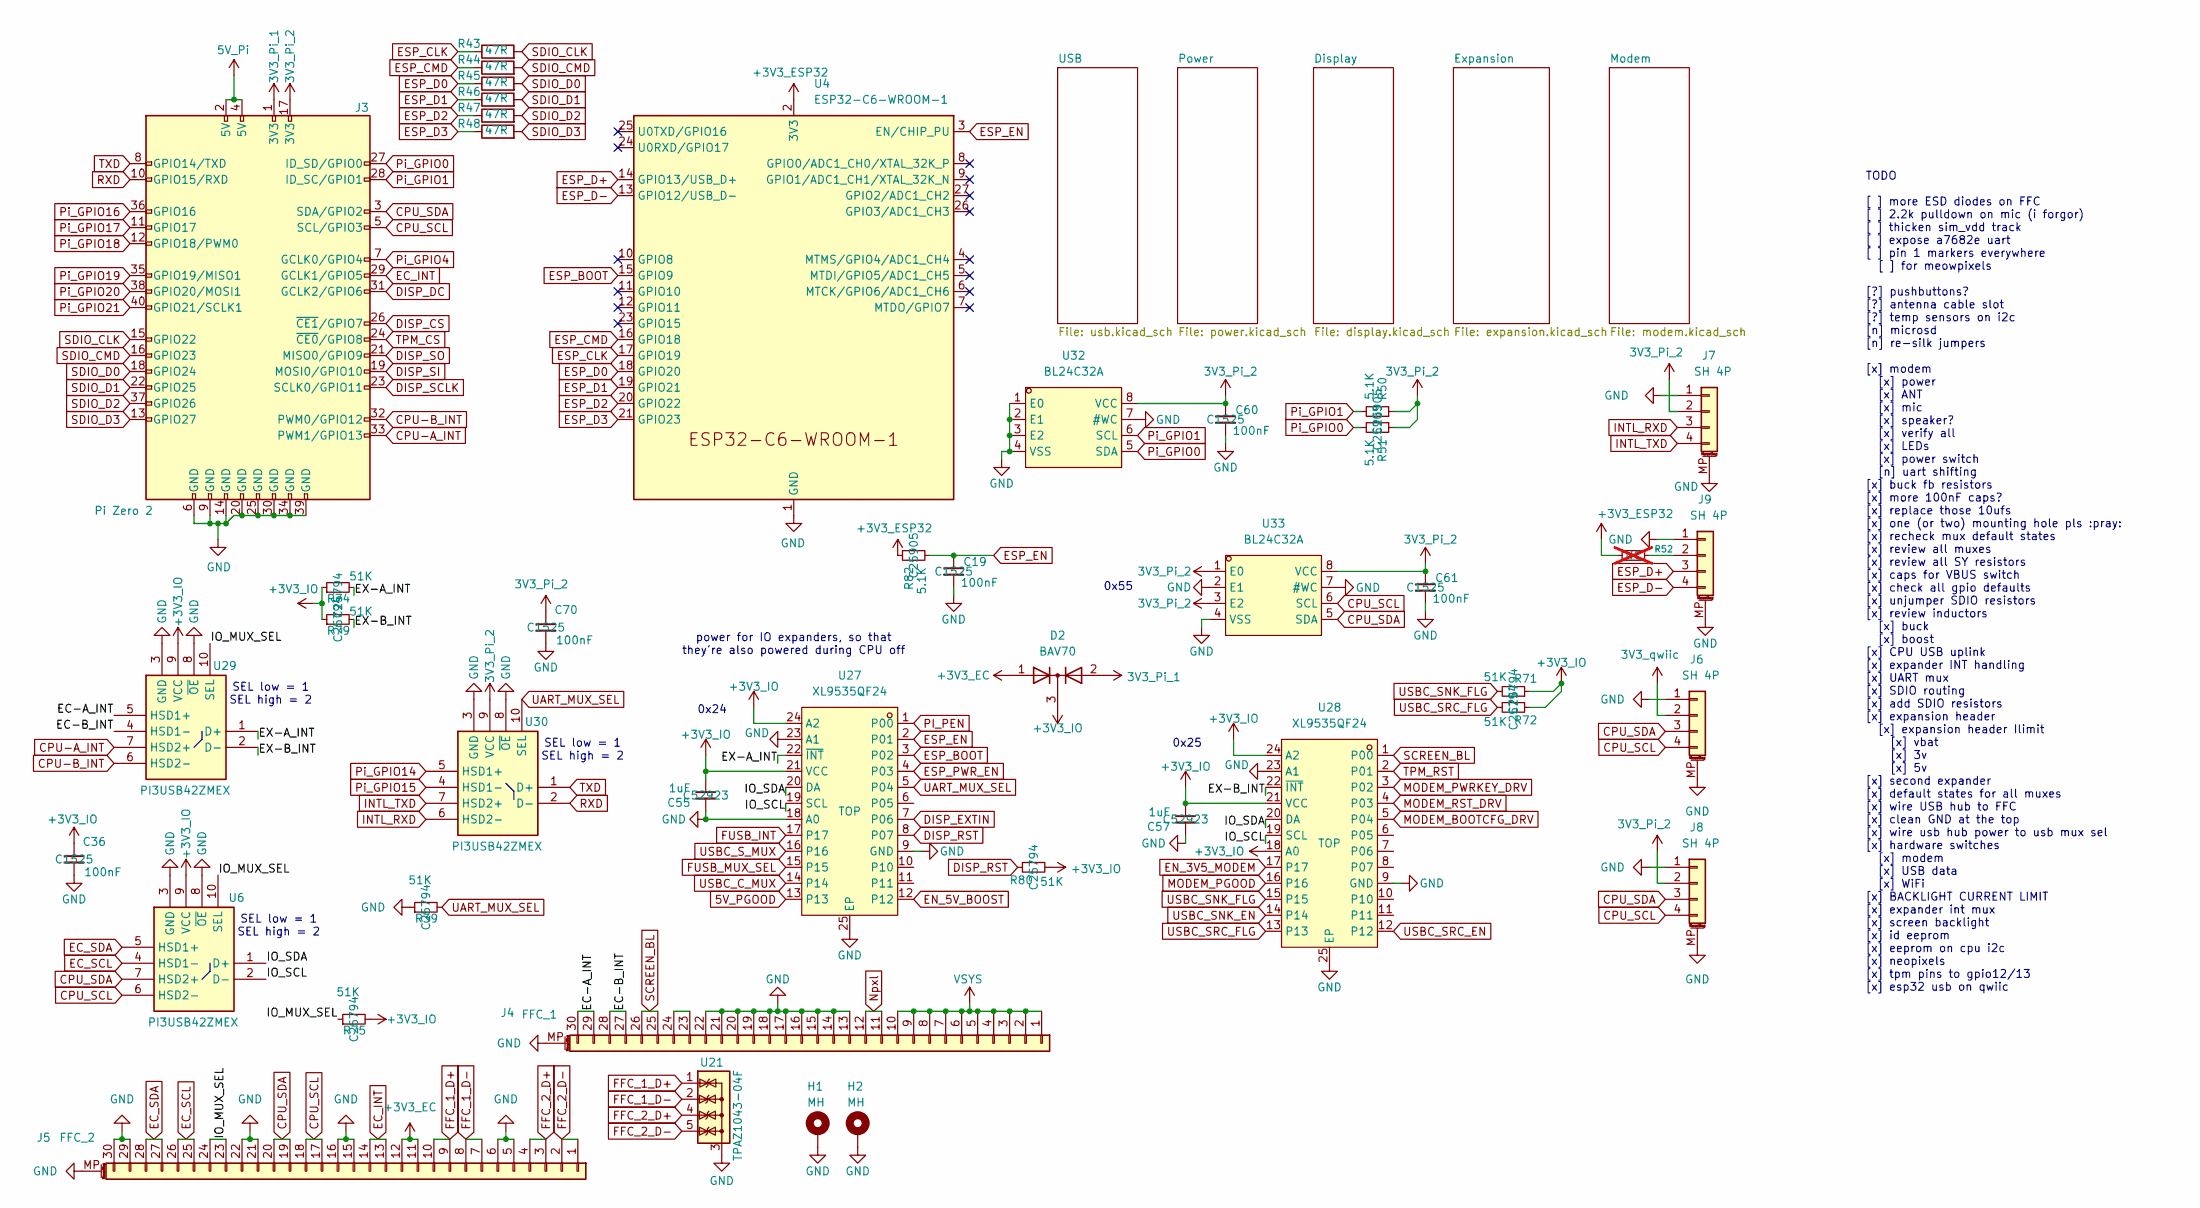
[picture p12: schematic top_board_pizero.kicad_sch]

Parts:
C19, C36, C60, C61, C70: 100nF; C_0402_1005Metric; LCSC Part C1525
C55, C57: 1uF; C_0402_1005Metric; LCSC Part C52923
D2: BAV70; SOT-23; LCSC Part C2501
H1, H2: MH; MountingHole_2.5mm_Pad
J3: Pi Zero 2; Raspberry_Pi_Zero_Socketed_THT_FaceDown_MountingHoles
J4: FFC_1; FPC-SMD_30P-P0.50_XF3M-3015-1B; LCSC Part C5700582
J5: FFC_2; FPC-SMD_30P-P0.50_XF3M-3015-1B; LCSC Part C5700582
J6, J7, J8, J9: SH 4P; JST_SH_SM04B-SRSS-TB_1x04-1MP_P1.00mm_Horizontal; LCSC Part C970137
R39, R71, R72, R74, R75, R79, R80: 51K; R_0402_1005Metric; LCSC Part C25794
R43, R44, R45, R46, R47, R48: 47R; R_0402_1005Metric; LCSC Part C25118
R50, R51, R82: 5.1K; R_0402_1005Metric; LCSC Part C25905
R52: NC; R_0402_1005Metric; not fitted
U4: ESP32-C6-WROOM-1
U6, U29, U30: PI3USB42ZMEX; QFN40P140X180X55-10N; Manufacturer_Part_Number FSUSB42UMX; Mouser Part Number 512-FSUSB42UMX
U21: TPAZ1043-04F; USON-10_2.5x1.0mm_P0.5mm
U27, U28: XL9535QF24; QFN-24-1EP_4x4mm_P0.5mm_EP2.5x2.5mm; LCSC Part C5444301
U32, U33: BL24C32A; DFN-8-1EP_3x2mm_P0.5mm_EP1.3x1.5mm; LCSC Part C691878

Connections:
3V3_Pi_1: D2.2 (A), J3.1 (3V3)
3V3_Pi_2: C60.1, C61.1, C70.1, J3.17 (3V3), J7.2, J8.2, R50.1, R51.1, U30.9 (VCC), U32.8 (VCC), U33.1 (E0), U33.3 (E2), U33.8 (VCC)
3V3_qwiic: J6.2
5V_PGOOD: U27.13
5V_Pi: J3.2 (5V), J3.4 (5V)
+3V3_EC: D2.1 (A), J5.11, J5.12
+3V3_ESP32: R52.2, R82.1, U4.2 (3V3)
+3V3_IO: C36.1, C55.1, C57.1, D2.3 (K), R71.1, R72.1, R74.1, R75.2, R79.1, R80.2, U6.9 (VCC), U27.21 (VCC), U27.24 (A2), U28.18 (A0), U28.21 (VCC), U28.24 (A2), U29.9 (VCC)
CPU-A_INT: J3.33 (PWM1/GPIO13), U29.7 (HSD2+)
CPU-B_INT: J3.32 (PWM0/GPIO12), U29.6 (HSD2-)
CPU_SCL: J3.5 (SCL/GPIO3), J5.17, J5.18, J6.4, J8.4, U6.6 (HSD2-), U33.6 (SCL)
CPU_SDA: J3.3 (SDA/GPIO2), J5.19, J5.20, J6.3, J8.3, U6.7 (HSD2+), U33.5 (SDA)
DISP_CS: J3.26 (~CE1/GPIO7)
DISP_DC: J3.31 (GCLK2/GPIO6)
DISP_EXTIN: U27.7 (P06)
DISP_RST: R80.1, U27.8 (P07)
DISP_SCLK: J3.23 (SCLK0/GPIO11)
DISP_SI: J3.19 (MOSI0/GPIO10)
DISP_SO: J3.21 (MISO0/GPIO9)
EC-A_INT: J4.29, J4.30, U29.5 (HSD1+)
EC-B_INT: J4.27, J4.28, U29.4 (HSD1-)
EC_INT: J3.29 (GCLK1/GPIO5), J5.13, J5.14
EC_SCL: J5.25, J5.26, U6.4 (HSD1-)
EC_SDA: J5.27, J5.28, U6.5 (HSD1+)
EN_3V5_MODEM: U28.17
EN_5V_BOOST: U27.12
ESP_BOOT: U4.15 (GPIO9), U27.3 (P02)
ESP_CLK: R43.1, U4.17 (GPIO19)
ESP_CMD: R44.1, U4.16 (GPIO18)
ESP_D0: R45.1, U4.18 (GPIO20)
ESP_D1: R46.1, U4.19 (GPIO21)
ESP_D2: R47.1, U4.20 (GPIO22)
ESP_D3: R48.1, U4.21 (GPIO23)
ESP_D+: J9.3, U4.14 (GPIO13/USB_D+)
ESP_D-: J9.4, U4.13 (GPIO12/USB_D-)
ESP_EN: C19.1, R82.2, U4.3 (EN/CHIP_PU), U27.2 (P01)
ESP_PWR_EN: U27.4 (P03)
EX-A_INT: R74.2, U27.22 (~INT), U29.1 (D+)
EX-B_INT: R79.2, U28.22 (~INT), U29.2 (D-)
FFC_1_D+: J5.9, J5.10, U21.1 (IO1), U21.10 (NC)
FFC_1_D-: J5.7, J5.8, U21.2 (IO2), U21.9 (NC)
FFC_2_D+: J5.3, J5.4, U21.4 (IO3), U21.7 (NC)
FFC_2_D-: J5.1, J5.2, U21.5 (IO4), U21.6 (NC)
FUSB_INT: U27.17
FUSB_MUX_SEL: U27.15
GND: C19.2, C36.2, C55.2, C57.2, C60.2, C61.2, C70.2, H1.1, H2.1, J3.6 (GND), J3.9 (GND), J3.14 (GND), J3.20 (GND), J3.25 (GND), J3.30 (GND), J3.34 (GND), J3.39 (GND), J4.13, J4.14, J4.15, J4.16, J4.17, J4.18, J4.19, J4.20, J4.21, J4.22, J4.MP (MountPin), J5.5, J5.6, J5.15, J5.16, J5.21, J5.22, J5.29, J5.30, J5.MP (MountPin), J6.1, J6.MP (MountPin), J7.1, J7.MP (MountPin), J8.1, J8.MP (MountPin), J9.1, J9.MP (MountPin), R39.1, U4.1 (GND), U4.28 (GND), U4.29 (GND), U6.3 (GND), U6.8 (~OE), U21.3 (G), U21.8 (G), U27.9 (GND), U27.18 (A0), U27.23 (A1), U27.25 (EP), U28.9 (GND), U28.23 (A1), U28.25 (EP), U29.3 (GND), U29.8 (~OE), U30.3 (GND), U30.8 (~OE), U32.1 (E0), U32.2 (E1), U32.3 (E2), U32.4 (VSS), U32.7 (#WC), U33.2 (E1), U33.4 (VSS), U33.7 (#WC)
INTL_RXD: J7.3, U30.6 (HSD2-)
INTL_TXD: J7.4, U30.7 (HSD2+)
IO_MUX_SEL: J5.23, J5.24, R75.1, U6.10 (SEL), U29.10 (SEL)
IO_SCL: U6.2 (D-), U27.19 (SCL), U28.19 (SCL)
IO_SDA: U6.1 (D+), U27.20 (DA), U28.20 (DA)
MODEM_BOOTCFG_DRV: U28.5 (P04)
MODEM_PGOOD: U28.16
MODEM_PWRKEY_DRV: U28.3 (P02)
MODEM_RST_DRV: U28.4 (P03)
unnamed: J4.23, J4.24
unnamed: J9.2, R52.1
Npxl: J4.11, J4.12
PI_PEN: U27.1 (P00)
Pi_GPIO0: J3.27 (ID_SD/GPIO0), R51.2, U32.5 (SDA)
Pi_GPIO1: J3.28 (ID_SC/GPIO1), R50.2, U32.6 (SCL)
Pi_GPIO4: J3.7 (GCLK0/GPIO4)
Pi_GPIO14: U30.5 (HSD1+)
Pi_GPIO15: U30.4 (HSD1-)
Pi_GPIO16: J3.36 (GPIO16)
Pi_GPIO17: J3.11 (GPIO17)
Pi_GPIO18: J3.12 (GPIO18/PWM0)
Pi_GPIO19: J3.35 (GPIO19/MISO1)
Pi_GPIO20: J3.38 (GPIO20/MOSI1)
Pi_GPIO21: J3.40 (GPIO21/SCLK1)
RXD: J3.10 (GPIO15/RXD), U30.2 (D-)
SCREEN_BL: J4.25, J4.26, U28.1 (P00)
SDIO_CLK: J3.15 (GPIO22), R43.2
SDIO_CMD: J3.16 (GPIO23), R44.2
SDIO_D0: J3.18 (GPIO24), R45.2
SDIO_D1: J3.22 (GPIO25), R46.2
SDIO_D2: J3.37 (GPIO26), R47.2
SDIO_D3: J3.13 (GPIO27), R48.2
TPM_CS: J3.24 (~CE0/GPIO8)
TPM_RST: U28.2 (P01)
TXD: J3.8 (GPIO14/TXD), U30.1 (D+)
UART_MUX_SEL: R39.2, U27.5 (P04), U30.10 (SEL)
USBC_C_MUX: U27.14
USBC_SNK_EN: U28.14
USBC_SNK_FLG: R71.2, U28.15
USBC_SRC_EN: U28.12
USBC_SRC_FLG: R72.2, U28.13
USBC_S_MUX: U27.16
VSYS: J4.1, J4.2, J4.3, J4.4, J4.5, J4.6, J4.7, J4.8, J4.9, J4.10

Notes on the sheet:
0x55
SEL low = 1 SEL high = 2
TODO [ ] more ESD diodes on FFC [ ] 2.2k pulldown on mic (i forgor) [ ] thicken sim_vdd track [ ] expose a7682e uart [ ] pin 1 markers everywhere [ ] for meowpixels [?] pushbuttons? [?] antenna cable slot [?] temp sensors on i2c [n] microsd [n] re-silk jumpers [x] modem [x] power [x] ANT [x] mic [x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
0x24
0x25
power for IO expanders, so that they're also powered during CPU off
