ZeroPhone/ZeroPhoneNext-PCB/top_board_pizero/usb.kicad_sch

## KiCad design top_board_pizero/usb.kicad_sch (2026-03-20)

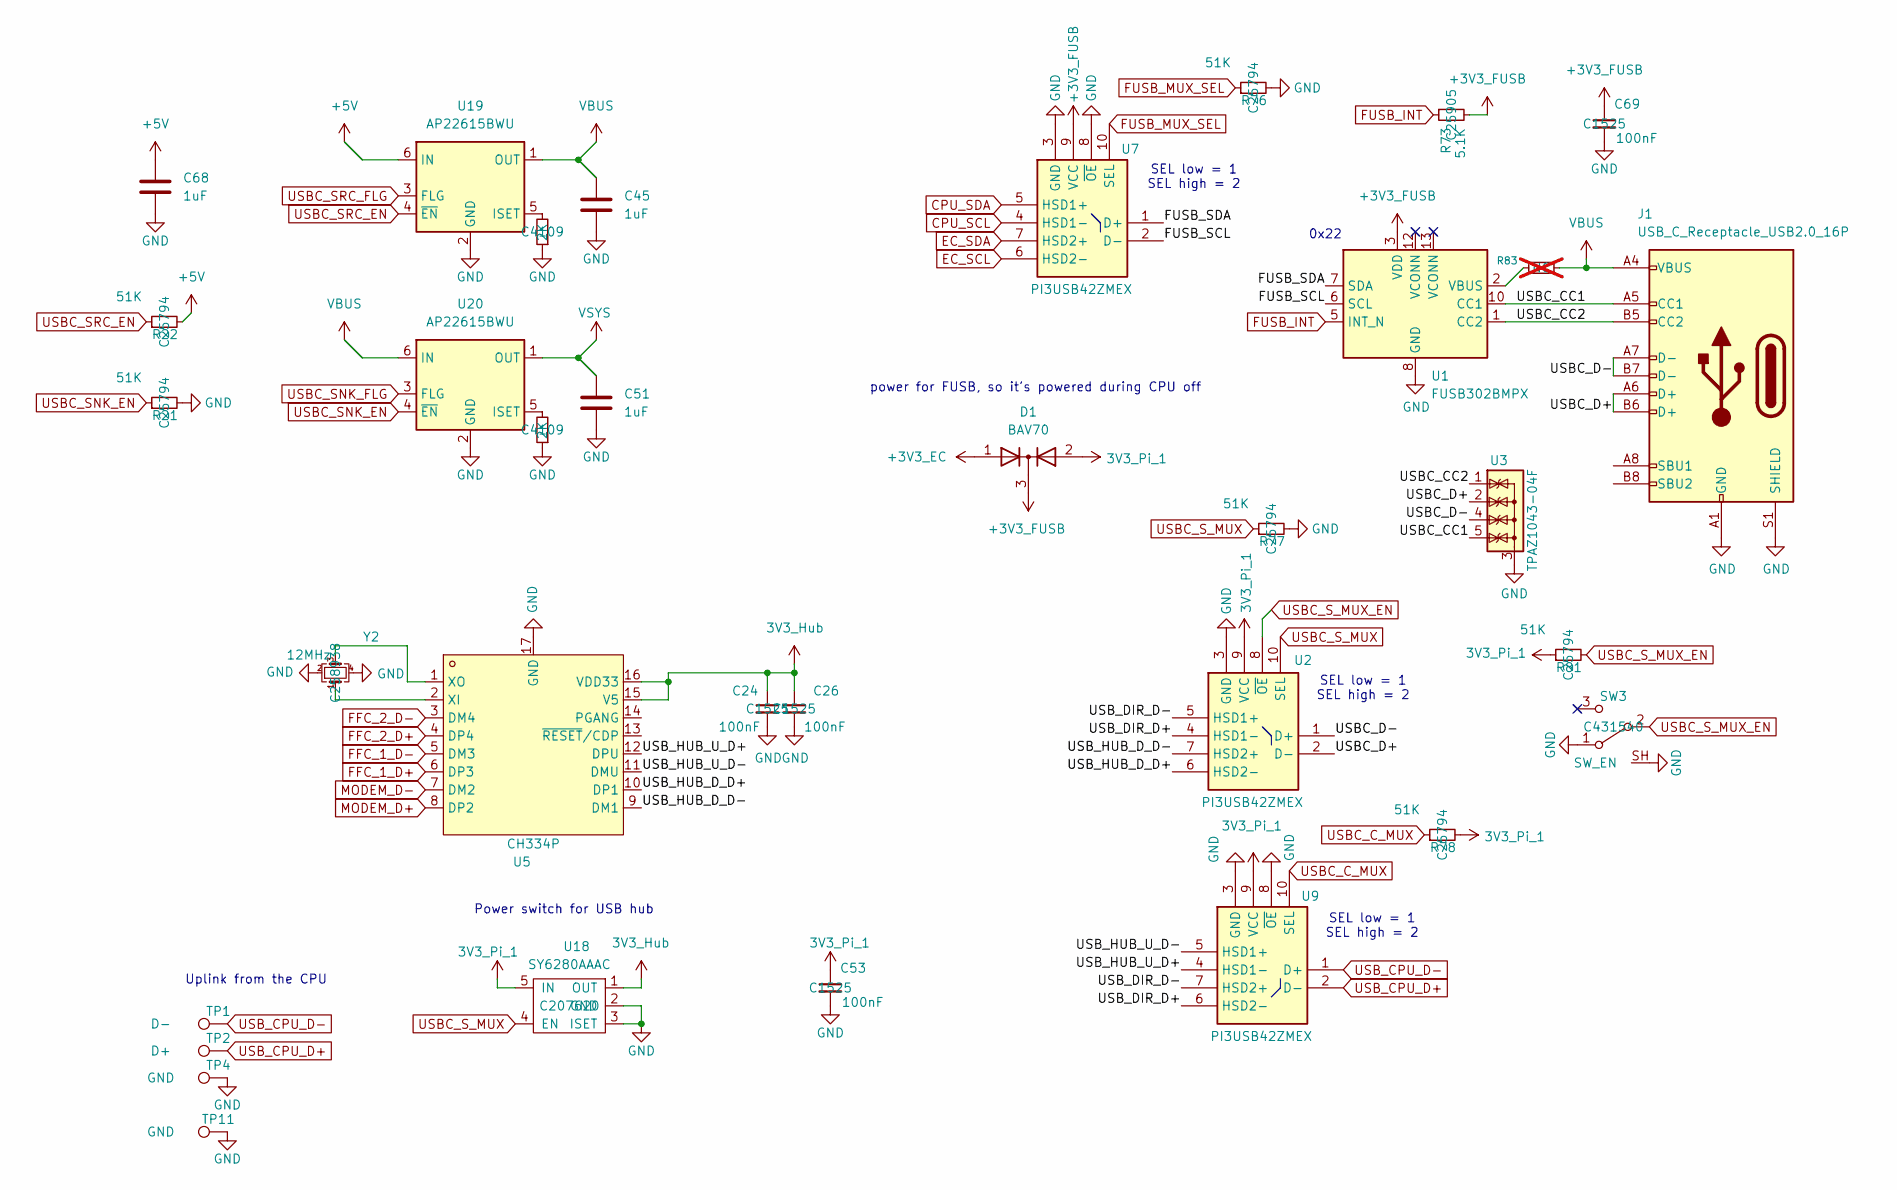
[picture p13: schematic usb.kicad_sch]

Parts:
C24, C26, C53, C69: 100nF; C_0402_1005Metric; LCSC Part C1525
C45, C51, C68: 1uF; C_0805_2012Metric_Pad1.18x1.45mm_HandSolder
D1: BAV70; SOT-23; LCSC Part C2501
J1: USB_C_Receptacle_USB2.0_16P; USB_C_Receptacle_HRO_TYPE-C-31-M-12; LCSC Part C165948
R21, R22, R76, R77, R78, R81: 51K; R_0402_1005Metric; LCSC Part C25794
R73: 5.1K; R_0402_1005Metric; LCSC Part C25905
R83: NC; R_0402_1005Metric; not fitted
R119, R120: 2K; R_0402_1005Metric; LCSC Part C4109
SW3: SW_EN; SW_SPDT_PCM12_SH; LCSC Part C431540
TP1: D-; TestPoint_Pad_1.0x1.0mm
TP2: D+; TestPoint_Pad_1.0x1.0mm
TP4, TP11: GND; TestPoint_Pad_1.0x1.0mm
U1: FUSB302BMPX; WQFN-14-1EP_2.5x2.5mm_P0.5mm_EP1.45x1.45mm
U2, U7, U9: PI3USB42ZMEX; QFN40P140X180X55-10N; Manufacturer_Part_Number FSUSB42UMX; Mouser Part Number 512-FSUSB42UMX
U3: TPAZ1043-04F; USON-10_2.5x1.0mm_P0.5mm
U5: CH334P; QFN-16-1EP_3x3mm_P0.5mm_EP1.7x1.7mm; LCSC Part C5373042
U18: SY6280AAAC; SOT-23-5; LCSC Part C207620
U19, U20: AP22615BWU; SOT-23-6
Y2: 12MHz; Crystal_SMD_3225-4Pin_3.2x2.5mm; LCSC Part C258938

Connections:
3V3_Hub: C24.1, C26.1, U5.15 (V5), U5.16 (VDD33), U18.1 (OUT)
3V3_Pi_1: C53.1, D1.2 (A), R78.2, R81.1, U2.9 (VCC), U9.9 (VCC), U18.5 (IN)
+3V3_EC: D1.1 (A)
+3V3_FUSB: C69.1, D1.3 (K), R73.2, U1.3 (VDD), U1.4 (VDD), U7.9 (VCC)
+5V: C68.1, R22.2, U19.6 (IN)
CPU_SCL: U7.4 (HSD1-)
CPU_SDA: U7.5 (HSD1+)
EC_SCL: U7.6 (HSD2-)
EC_SDA: U7.7 (HSD2+)
FFC_1_D+: U5.6 (DP3)
FFC_1_D-: U5.5 (DM3)
FFC_2_D+: U5.4 (DP4)
FFC_2_D-: U5.3 (DM4)
FUSB_INT: R73.1, U1.5 (INT_N)
FUSB_MUX_SEL: R76.1, U7.10 (SEL)
FUSB_SCL: U1.6 (SCL), U7.2 (D-)
FUSB_SDA: U1.7 (SDA), U7.1 (D+)
GND: C24.2, C26.2, C45.2, C51.2, C53.2, C68.2, C69.2, J1.A1 (GND), J1.A12 (GND), J1.B1 (GND), J1.B12 (GND), J1.S1 (SHIELD), R21.2, R76.2, R77.2, R119.1, R120.1, SW3.1 (A), SW3.SH, TP4.1, TP11.1, U1.8 (GND), U1.9 (GND), U1.15 (GND), U2.3 (GND), U3.3 (G), U3.8 (G), U5.17 (GND), U7.3 (GND), U7.8 (~OE), U9.3 (GND), U9.8 (~OE), U18.2 (GND), U18.3 (ISET), U19.2 (GND), U20.2 (GND), Y2.2, Y2.4
MODEM_D+: U5.8 (DP2)
MODEM_D-: U5.7 (DM2)
unnamed: R83.1, U1.2 (VBUS)
unnamed: R119.2, U20.5 (ISET)
unnamed: R120.2, U19.5 (ISET)
unnamed: U5.1 (XO), Y2.3
unnamed: U5.2 (XI), Y2.1
USBC_CC1: J1.A5 (CC1), U1.10 (CC1), U1.11 (CC1), U3.5 (IO4), U3.6 (NC)
USBC_CC2: J1.B5 (CC2), U1.1 (CC2), U1.14 (CC2), U3.1 (IO1), U3.10 (NC)
USBC_C_MUX: R78.1, U9.10 (SEL)
USBC_D+: J1.A6 (D+), J1.B6 (D+), U2.2 (D-), U3.2 (IO2), U3.9 (NC)
USBC_D-: J1.A7 (D-), J1.B7 (D-), U2.1 (D+), U3.4 (IO3), U3.7 (NC)
USBC_SNK_EN: R21.1, U20.4 (~EN)
USBC_SNK_FLG: U20.3 (FLG)
USBC_SRC_EN: R22.1, U19.4 (~EN)
USBC_SRC_FLG: U19.3 (FLG)
USBC_S_MUX: R77.1, U2.10 (SEL), U18.4 (EN)
USBC_S_MUX_EN: R81.2, SW3.2 (B), U2.8 (~OE)
USB_CPU_D+: TP2.1, U9.2 (D-)
USB_CPU_D-: TP1.1, U9.1 (D+)
USB_DIR_D+: U2.4 (HSD1-), U9.6 (HSD2-)
USB_DIR_D-: U2.5 (HSD1+), U9.7 (HSD2+)
USB_HUB_D_D+: U2.6 (HSD2-), U5.10 (DP1)
USB_HUB_D_D-: U2.7 (HSD2+), U5.9 (DM1)
USB_HUB_U_D+: U5.12 (DPU), U9.4 (HSD1-)
USB_HUB_U_D-: U5.11 (DMU), U9.5 (HSD1+)
VBUS: C45.1, J1.A4 (VBUS), J1.A9 (VBUS), J1.B4 (VBUS), J1.B9 (VBUS), R83.2, U19.1 (OUT), U20.6 (IN)
VSYS: C51.1, U20.1 (OUT)

Notes on the sheet:
0x22
power for FUSB, so it's powered during CPU off
Power switch for USB hub
Uplink from the CPU
SEL low = 1 SEL high = 2
