ZeroPhone/ZeroPhoneNext-PCB/(commit log)

2026-03-20 Initial commit: top_board_pizero v0, almost as-ordered (added silk under expansion headers in the meantime)
    [CMNSM661004.stp, FSUSB42UMX.stp, display.kicad_sch, expansion.kicad_sch, modem.kicad_sch, power.kicad_sch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]
2026-03-29 bottom_board_palmtop: initial commit
    [FSUSB42UMX.stp, battery.kicad_sch, bbq20kbd.kicad_sch, bottom_board_palmtop.kicad_sch, keyboard.kicad_sch, peripherals.kicad_sch, usb.kicad_sch]
2026-03-30 bottom_board_palmtop: JLC PCBA preparation; clarifying I2C addresses in use
    [battery.kicad_sch, bottom_board_palmtop.kicad_sch, keyboard.kicad_sch, peripherals.kicad_sch, usb.kicad_sch]
2026-03-30 removing and gitignoreing jlcpcb production files
    [top_board_pizero-CuBottom.gbr, top_board_pizero-CuTop.gbr, top_board_pizero-EdgeCuts.gbr, top_board_pizero-MaskBottom.gbr, top_board_pizero-MaskTop.gbr, top_board_pizero-NPTH.drl, top_board_pizero-PTH.drl, top_board_pizero-SilkBottom.gbr]
2026-03-30 small tweaks post-ordering (todo entries and step export settings)
    [top_board_pizero.kicad_sch]
2026-03-30 bottom_board_palmtop: adding board name, credits, a little silk
2026-03-31 adding project logo and reorganizing silk, adding 5v testpoint to touchpad module +a few tiny track tweaks
    [peripherals.kicad_sch]
2026-03-31 changing JST-SH 2p connectors to vertical, poking board art around and adding more
    [battery.kicad_sch, peripherals.kicad_sch]
